lin-gengyou/py32-kitchen-scale/REQUIREMENTS.md

# 需求与实现对照 · v2.0.1

依据项目方确认的两份5kg V1.0文档，以及用户补充：SW4独立操作、单点20g默认标定、空秤稳定无操作120秒软件待机、外部供电默认、恢复ECB01C蓝牙。

| 需求 | 实现 |
|---|---|
| 称重链路 | HX711 A/128、10SPS；3点中值、动态3点/静态8点平均；默认按标定换算0.2g峰峰门限、8点满足500ms；2倍退出门限与均值锚点防慢漂 |
| 5000g量程 | >5000g为RANGE，≥5250g为OL；按毛重限制，去皮后容量保护继续生效 |
| 分度 | 0.1/0.5/1g，边界带滞回；内部mg计算，负净重与0.5g小负载保留 |
| 启动归零 | 保存空秤基线附近±0.1g，原始与滤波均稳定时归零；0.5g真实负载保持 |
| 去皮/归零 | SW4短按去皮、长按归零、菜单01清皮；BLE TARE复用新鲜/稳定/量程检查 |
| 显示 | HT1621B：重量、单位、稳定/皮重/负号、标定/菜单/故障；默认跳过数值第三位，菜单19恢复6位 |
| 标定 | 菜单07，1～3点、默认20g单点，各点1～5000g递增，正负ADC方向；最后一点整体提交 |
| 本机操作 | 菜单01～21包含全部设备设置、查看、维护，见按键指南 |
| 提示音 | 成功1声、错误3声，称重异常约每2秒3声；静音/有源/无源500Hz；1ms中断产生无源方波 |
| 电源 | 默认外部供电：电量-1、可查看输入与VDDA电压；可选锂电/碱性/镍氢、电压百分比、低电滞回与ADC故障恢复 |
| 待机 | 已知空秤、无皮重、稳定近零、无操作120秒；关闭LCD/HX711/LED，SW4或WAKE唤醒；PING保持待机 |
| 参数 | V4双128B记录、CRC32、代数序号、半页损坏回退、相同参数免写；V1/V2/V3迁移 |
| 元数据 | 板上录入设备编号/标定日期；版本2.0.1；发布包SHA256SUMS与源码哈希manifest |
| 蓝牙 | 9600/8N1、FFF0/FFF1/FFF2，5～10Hz重量、带序号去皮与成功/失败去重、状态同步/心跳/唤醒 |
| 终端界面 | 浏览器显示净重/稳定/皮重/电源/错误、g/kg/oz/lb:oz、去皮/唤醒、分包/粘包、超时重试、断线重连并重新订阅 |
| 可靠性 | 约4秒IWDG，DBGMCU时钟与暂停冻结；程序16KB、独立4KB配置区 |
| 彩屏 | 可操作界面预览、共享总线与资源方案见docs/color-display.md；型号尚未知，当前主显示为段码LCD |

## 软件检查

四个PIO环境构建；真实按键时序模拟；20g单点与1/2/3点正负标定；非线性净重、毛重限值、负数、0.5g保持、待机/唤醒、超时/回绕；V1/V2/V3迁移和全部半页写入截断；电压/百分比/低电滞回/故障门控；稳定噪声/真实0.5g阶跃/慢加料/手动门限；5位显示绕行；BLE分包/去重/失败缓存/旧序号/回绕/不交错发送。

合成8小时10Hz共288000帧，合成24小时10SPS共864000样本。浏览器协议和模拟GATT界面覆盖连接、去皮ACK、单位转换、断线空白、重连订阅、主动断开和演示。

## 整机验收指标

| 指标 | 测量方法 |
|---|---|
| 0.5g起称、分区±0.2/±1/±3g | 安装完成的5kg传感器与秤盘、对应区间标准砝码。20g为当前入门标定点，使用更大质量核对全量程 |
| 静态稳定≤1.5秒 | 实际加载到稳定标志的时间，包含机械振动、ADC建立与采样 |
| 重复10次、四角偏载 | 同砝码重复放置及改变位置 |
| 空秤10分钟漂移≤0.5g | 固定安装、温度和供电 |
| BLE 8小时、整机24小时 | 实物模块/终端/无线环境/传感器连续记录，与合成调度检查分别计量 |

显示实物反馈：数值第三位全亮仍为7，而HT1621的32项RAM读回正确。当前版正常显示绕过该位，自检仍点亮所有物理段。v2.0.1已通过CMSIS-DAP下载，并核对程序字节与4KB配置区保留；运行时已恢复20g旧标定并测得正常ADC状态，VDDA约5.1V。全量程误差与无线长测按上表继续测量。

原始依据：[产品需求](docs/requirements/01_厨房电子秤产品需求规格书_5kg_V1.0.docx)、[设计说明](docs/requirements/02_厨房电子秤项目设计说明书_5kg_V1.0.docx)。操作：[完整指南](docs/button-guide.md)。
