lin-gengyou/py32-kitchen-scale/docs/requirements/01_厨房电子秤产品需求规格书_5kg_V1.0.docx

厨房电子秤产品需求规格书

5 kg量程 · 简版

硬件平台：PY32F002A + HX711 + ECB01C + 显示屏 + 按键 + 蜂鸣器

文档项目 | 内容
文档类型 | 电子秤需求产出
文档版本 | V1.0
产品量程 | 最大称量 5000 g
产品定位 | 家用及教学烹饪辅助称重，不用于贸易结算
编制日期 | 2026年10月30日

# 1 产品定位

本产品是一台5 kg厨房电子秤，主要用于家庭做饭、烘焙、配料和教学做菜。用户可以一次放上物体称重，也可以放置容器后去皮，再边加料边观察重量。电子秤可与RK3566小平板通过蓝牙联动，但不用于商品贸易结算。

# 2 主要指标

项目 | 要求 | 说明
最大量程 | 5000 g | 已确认
起称目标 | 0.5 g | 小于0.5 g也不强制归零，尽量显示实测值
显示分度 | ≤200 g：0.1 g >200～1000 g：0.5 g >1000～5000 g：1 g | 分段显示，阈值附近防止反复跳变
目标误差 | ±0.2 g / ±1 g / ±3 g | 分别对应三个重量区间
稳定时间 | ≤1.5秒 | 静态加载、秤台无明显振动
刷新速度 | 约5～10次/秒 | 支持连续加料
超载提示 | 约5250 g以上显示OL | 停止输出正常重量

说明：低重量段0.1 g显示、0.5 g起称和±0.2 g误差均为优先设计目标。不得把低于2 g的物体直接归零；最终能力以5 kg传感器、秤台和整机测试结果为准。

# 3 功能需求

功能 | 简要要求
开机归零 | 确认空秤且稳定后归零；平台晃动或检测到小重量时不更新零点
去皮 | 实体按键和平板都能去皮；不稳定时拒绝去皮并提示
稳定显示 | 动态时实时变化，稳定后显示稳定标志
负重量 | 取走已去皮容器后允许显示负值，不强制清零
异常提示 | 超载显示OL；传感器异常显示ERR；低电显示电量提醒
单位 | 基本单位为g，可扩展kg、oz、lb:oz
蜂鸣器 | 按键有效一声，成功一声，错误或超载三声，可静音
掉电保存 | 标定参数、单位、蜂鸣和自动关机设置掉电保存

# 4 蓝牙和平板要求

- 主控与ECB01C串口统一为9600 bps、8N1；手机和平板连接BLE不需要设置串口波特率。
- FFF1用于上报重量与状态，FFF2用于接收去皮等控制命令。
- 平板显示净重、稳定状态、连接状态、电量和错误；断线后自动重连。
- 去皮命令必须返回成功或失败结果，不能只看重量是否接近0来猜测。

# 5 验收要求

项目 | 通过条件
称重 | 使用0.5 g、1 g、2 g及更大关键砝码至5000 g测试，满足对应区间误差
稳定性 | 同一砝码重复10次，显示不明显跳动；空秤10分钟漂移≤0.5 g
去皮 | 稳定时成功归零，不稳定时拒绝；屏幕和平板结果一致
连续加料 | 重量连续变化，无明显停顿、倒跳或长时间拖尾
四角偏载 | 中心和四角加载均满足对应重量区间误差
异常 | 超载、断传感器、低电时提示正确，不输出伪造的正常重量
蓝牙 | 连续连接8小时不死机，断开后能重连，命令不重复执行

# 6 当前待确认

- 确定具体5 kg称重传感器型号，并确认灵敏度、综合误差、蠕变、温漂和过载能力。
- 冻结秤台结构、传感器安装方式和机械限位，再做四角偏载与全量程验证。
- 如果样机无法稳定达到0.5 g起称、0.1 g显示和±0.2 g低段误差，应优先改善传感器、供电和机械结构。
