lin-gengyou/py32-kitchen-scale/docs/requirements/02_厨房电子秤项目设计说明书_5kg_V1.0.docx

厨房电子秤项目设计说明书

5 kg量程 · 简版

硬件平台：PY32F002A + HX711 + ECB01C + 显示屏 + 按键 + 蜂鸣器

文档项目 | 内容
文档类型 | 项目设计文档
文档版本 | V1.0
产品量程 | 最大称量 5000 g
产品定位 | 家用及教学烹饪辅助称重，不用于贸易结算
编制日期 | 2026年10月30日

# 1 总体方案

项目继续使用现有硬件：PY32F002A主控、HX711、ECB01C蓝牙模块、现有显示屏、按键、蜂鸣器和电源电路；称重传感器选用5 kg单点式全桥传感器。固件按新的厨房秤需求重新设计，不受原程序结构限制。

模块 | 作用
5 kg传感器 | 把重量转换成微弱差分信号
HX711 | 采集传感器信号，默认A通道、128倍增益、10 SPS
PY32F002A | 滤波、标定换算、去皮、显示、蜂鸣和故障处理
ECB01C | 把主控串口数据透明传输到BLE
RK3566平板 | 显示重量、执行去皮、配合做菜流程

# 2 硬件设计

- 传感器使用5 kg铝合金单点梁、四线全桥，建议灵敏度1.0～2.0 mV/V。
- 传感器固定端和受力端按厂家图纸安装，秤盘中心与受力中心对齐。
- 秤台应有足够刚度和机械限位；线束、电池和外壳不能碰到秤盘形成分流力。
- HX711传感器线尽量使用屏蔽或双绞线，模拟供电稳定，去耦电容靠近芯片。
- 电池低电、充电和主控复位期间都要测试称重，避免电源变化造成跳重。

# 3 固件结构

任务 | 建议周期 | 工作内容
采样 | HX711数据就绪，约10 Hz | 读取原始ADC、检测超时
称重 | 每个新样本 | 滤波、标定、稳定判断、分度和超载
按键/蜂鸣 | 10 ms | 消抖、去皮请求、非阻塞音型
显示 | 100～200 ms | 刷新重量、单位、稳定、电量和错误
蓝牙 | 100～200 ms | 上报状态、接收命令、维护连接
电源/看门狗 | 500～1000 ms/按芯片配置 | 电量、自动关机、异常复位

所有任务都采用非阻塞方式，不能用长延时等待HX711、蜂鸣器或蓝牙。屏幕和平板使用同一个WeightState对象，避免两端显示不同结果。

# 4 称重与去皮算法

1. 读取HX711原始值，检查数据就绪、超时和异常范围。

2. 用中值或截尾均值去除偶发尖峰，再进行适度平滑，避免小重量被滤掉。

3. 减去零点Offset，应用比例系数或分段修正，得到未量化重量。

4. 状态机区分空秤、动态加载、稳定候选、稳定锁定、卸载和故障。

5. 按重量区间选择0.1 g、0.5 g或1 g分度，最后一步再四舍五入。

6. 生成统一WeightState，同时提供给屏幕和蓝牙。

状态 | 处理方式
空秤 | 仅在确认空秤、连续稳定≥3秒且净重绝对值≤0.1 g时慢速跟踪；检测到加载立即停止
动态加载 | 快速跟随，不显示稳定
稳定候选 | 连续多个样本波动小于阈值后确认稳定
稳定锁定 | 抑制小噪声；持续变化后返回动态
故障 | 停止正常重量发布，显示ERR并等待恢复自检

去皮时先检查最近重量是否稳定。稳定则保存新皮重、清空滤波状态并发布0；不稳定则保留旧皮重并返回UNSTABLE。普通称重时不得把低于2 g的物体直接归零。去皮只能改变净重零点，不能绕过5 kg总负载限制。

# 5 蓝牙和平板通信

项目 | 设计
主控↔ECB01C | 9600 bps、8N1、无流控；两边必须一致
BLE特征 | FFF1 Notify上报，FFF2 Write下发
重量帧 | W,序号,净重,稳定,皮重,电量,状态 + CRLF
去皮命令 | TARE,序号 + CRLF
命令应答 | ACK,TARE,序号 或 ERR,TARE,序号,原因
平板处理 | 按CRLF组帧，处理拆包、粘包、断线和自动重连

示例：W,1024,256.4,1,120.0,78,OK 表示序号1024、净重256.4 g、已稳定、皮重120.0 g、电量78%、状态正常。

# 6 标定与测试

1. 整机放在水平硬质台面，预热并检查秤盘没有机械干涉。

2. 空载采集零点，依次加载500 g、2500 g和5000 g砝码完成主标定。

3. 计算比例系数并检查线性，必要时保存分段修正参数。

4. 使用0.5 g、1 g、2 g、10 g、50 g和200 g砝码重点验证小重量，再测试重复性、回程、四角偏载和去皮。

5. 写入设备编号、标定参数、日期和固件版本，并用CRC校验。

6. 完成连续加料、超载、断传感器、低电、蓝牙重连和24小时运行测试。

- 标定参数使用双备份或版本号+CRC；写入失败时使用上一份有效参数。
- 具体5 kg传感器和秤台结构未冻结前，不承诺最终误差。
- 开发顺序建议：先验证传感器与秤台，再完成称重算法，然后联调蓝牙和平板，最后做整机验收。
