lin-gengyou/py32-kitchen-scale/docs/manuals/01_厨房电子秤功能逻辑与代码图解_1.0.2.pdf

### 开发阅读 / 源码与实际行为

# 厨房电子秤

# 功能逻辑与代码图解

## 5kg厨房秤 · PY32F002A / HX711 / ECB01C

## 固件开发版 1.0.2 · 协议 2 · 2026年11月5日

### 面向程序开发与联调阅读。按启动、采样、称重、交互、通信和参数恢复的顺序，把真实源码图与它产生的 实际行为配对说明。代码图保留文件名与行号，便于回到 VS Code 查阅。


### 阅读基线为当前本地固件开发版1.0.2。编译和桌面模拟已完成，实物烧录、称重精度、屏幕、电池和 无线链路的验收状态在正文逐项列出。

源代码快照 scale_basic.c / SHA256 0692ed771e531d16def9

固件1.0.2 / 协议2 · 代码与模拟状态见正文 | 1 / 43

功能逻辑与代码图解 | 阅读导航

# 如何阅读本册

### 每个模块按源码图、触发条件、处理过程和结果展开。代码图由当前源文件直接生成，长行仅作视觉折行， 续行不增加源代码行号。图下给出源码哈希前缀，完整快照信息见末页。

硬件输入、C 类型和默认参数 | 3
上电恢复、主循环和引脚初始化 | 6
HX711、尖峰处理、平均与判稳 | 10
分段标定、归零和去皮 | 15
错误状态、分度和重量帧 | 19
串口组帧、序号去重和命令 | 23
实体按键和蜂鸣提示 | 28
空秤跟踪、120秒待机和唤醒 | 30
双页配置、CRC和失败回退 | 33
看门狗、构建与验证范围 | 38
函数索引与来源快照 | 41

### 操作次序、PCB 接线、所有命令与错误处理，配套查阅第二册《PCB操作与联调指南》。本册的“预期 输出”说明代码行为，实物测试状态以验证页为准。

功能逻辑与代码图解 | 01 硬件与数据

# 代码如何对应到这块板

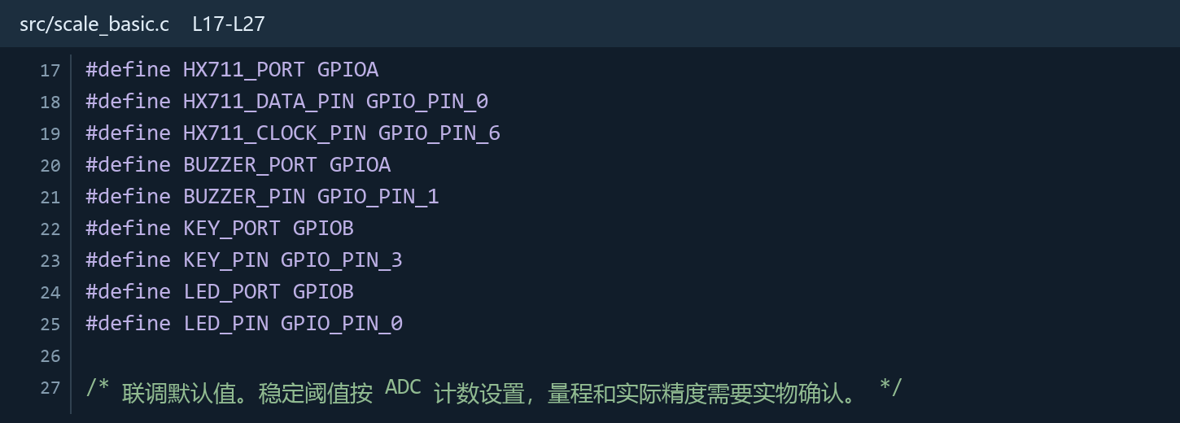
[picture p11: figure]

源码图 src/scale_basic.c 第 17-27 行 · SHA256 0692ed771e53

### 实际功能

网络或器件 | MCU 引脚 | 代码中的用途
HX711 DOUT / PD_SCK | PA0 / PA6 | 读取称重计数；时钟拉高还用于待机掉电
SW4 / LED2 | PB3 / PB0 | 功能键输入 / 运行心跳
蜂鸣器驱动 | PA1 | 有源通断或无源方波
ECB01C 串口 | PA2 TX / PA3 RX | 9600bps、8N1 收发
SWD | PA13 / PA14 | 保留给下载和调试
两块显示接口 | PA4 / PB2 片选 | 初始化为高，显示驱动待接入

宏名称把物理引脚集中在文件开头。后续阅读 KEY_PIN 或 HX711_CLOCK_PIN 时，可回到这里定位。电池

### 检测接 PB1，当前采样和百分比换算尚未实现。[H1]

功能逻辑与代码图解 | 01 硬件与数据

# 配置变量与统一重量状态

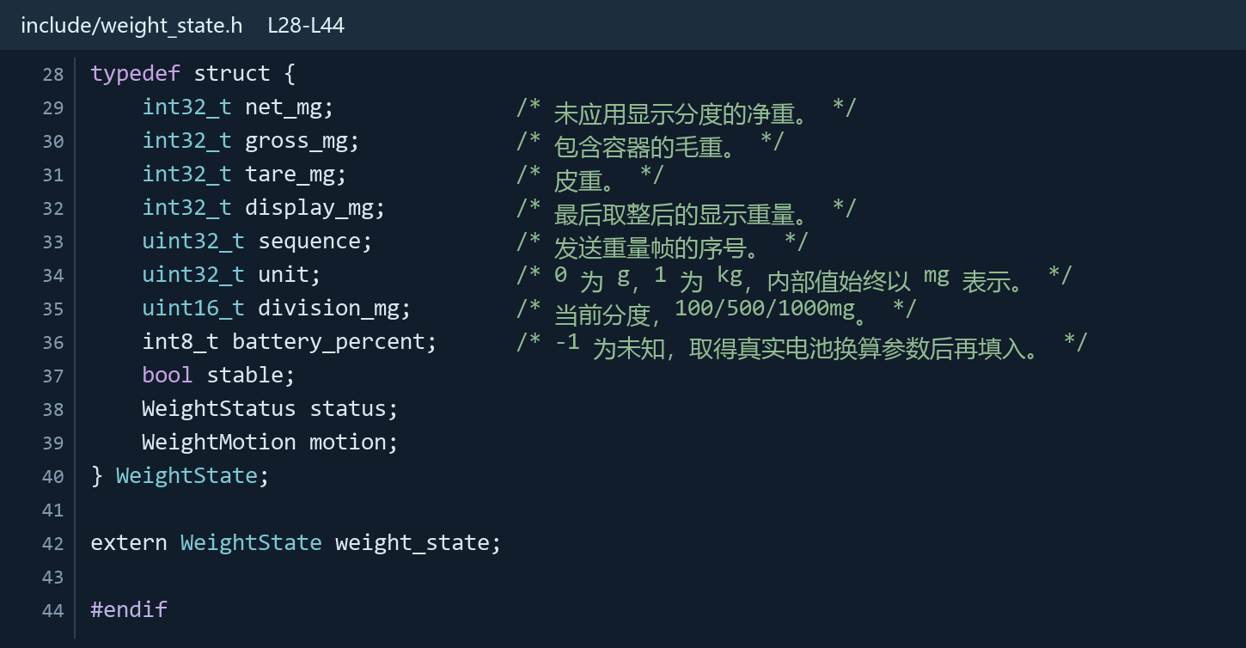
[picture p12: figure]

源码图 include/weight_state.h 第 28-44 行 · SHA256 d49d46442fe9

### 实际功能

WeightState 像一张当前测量状态表。net_mg、gross_mg 和 tare_mg 分别是未量化净重、毛重和皮重， display_mg 才是按分度取整后的数值。蓝牙使用这张表生成重量帧，屏幕驱动接入后也读取它。

表达式 | 用白话理解
battery_percent = -1 | 尚未得到电量数据，界面可显示“未知”或 --
division_mg = 100 | 分度100mg，即0.1g；这项数值描述显示步长
ScaleConfig saved_config | Flash 中参数的运行副本，保存标定、单位和待机等设置
static | 文件级变量只在当前 .c 文件内部直接访问
typedef / enum / bool | 给类型起名 / 定义可选状态 / 表示真或假

功能逻辑与代码图解 | 01 硬件与数据

# 默认数值分别控制什么

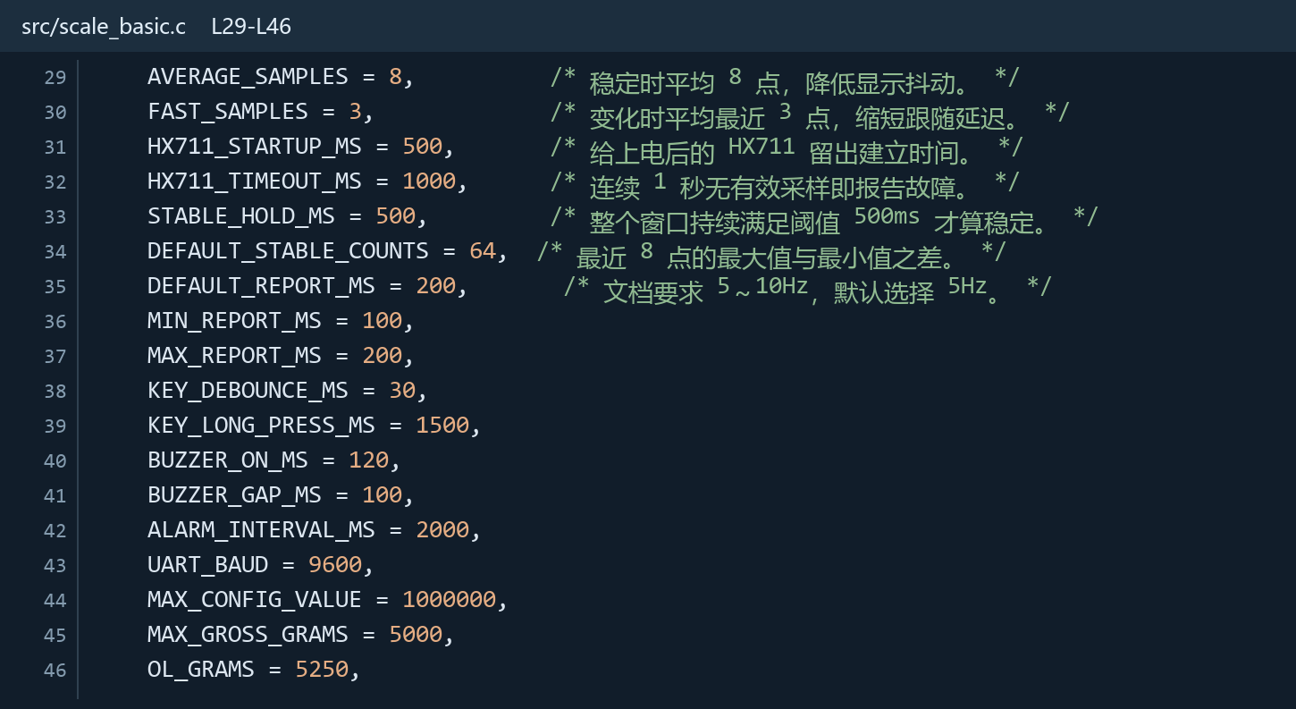
[picture p13: figure]

源码图 src/scale_basic.c 第 29-46 行 · SHA256 0692ed771e53

### 实际功能

参数 | 对应行为
8点 / 3点 | 稳定时平均8点，动态时平均最近3点
500ms / 1000ms | 上电建立时间 / 连续无有效读数的故障门限
64计数、500ms | 8点峰峰值不超过64且持续500ms后判稳
200ms，允许100～200ms | 默认每秒5帧，可设每秒5～10帧
30ms / 1500ms | 按键消抖 / 长按识别
120ms / 100ms | 每声持续时间 / 声间间隔

### 64 的单位是 ADC 计数。每克对应多少计数由传感器和标定决定，需要在样机上测噪声并调整。

功能逻辑与代码图解 | 02 启动与调度

# 上电后先恢复哪些东西

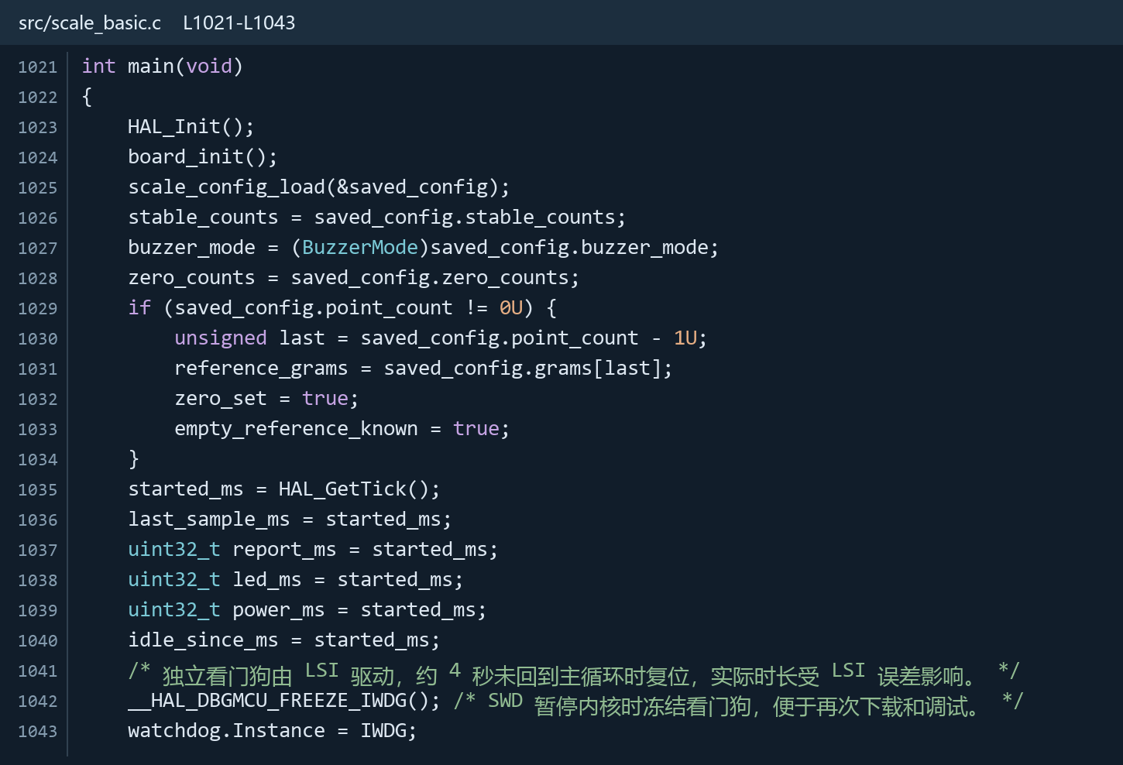
[picture p14: figure]

源码图 src/scale_basic.c 第 1021-1043 行 · SHA256 0692ed771e53

### 实际功能

### 先初始化 HAL 和板级引脚，再读取双页 Flash 配置。有效标定存在时，恢复空秤基线与标定点，允许进入 克数换算；没有有效标定时，恢复默认设置并上报 UNCAL。

### 皮重是本次运行的状态，上电初值为0。去皮序号缓存、消息序号、临时上报设置同样从初始值开始。已有 标定只提供空秤参考，开机放着0.5g物体时仍会保留这个真实负载。

功能逻辑与代码图解 | 02 启动与调度

# 主循环怎样并行照顾各功能

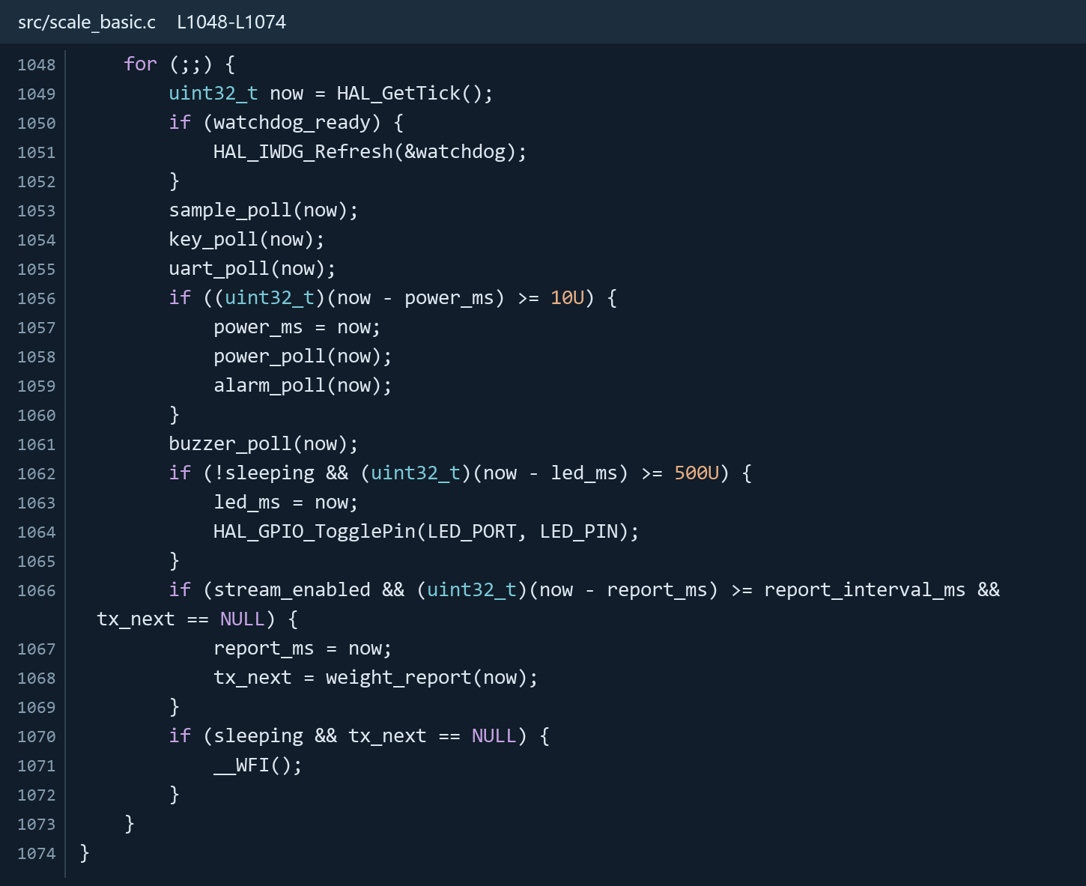
[picture p15: figure]

源码图 src/scale_basic.c 第 1048-1074 行 · SHA256 0692ed771e53

### 实际功能

每轮依次处理采样、按键、串口、蜂鸣器。电源与报警约每10ms检查一次，LED 每500ms翻转，重量按 100～200ms的周期发布。每个任务快速返回，下一轮继续检查。

### STREAM 0 只暂停周期上报。采样、按键、故障状态和心跳继续运行。待机时允许执行 WFI 等待中断，串 口或按键活动会唤醒任务流程。

功能逻辑与代码图解 | 02 启动与调度

# 引脚初始化为何先写电平

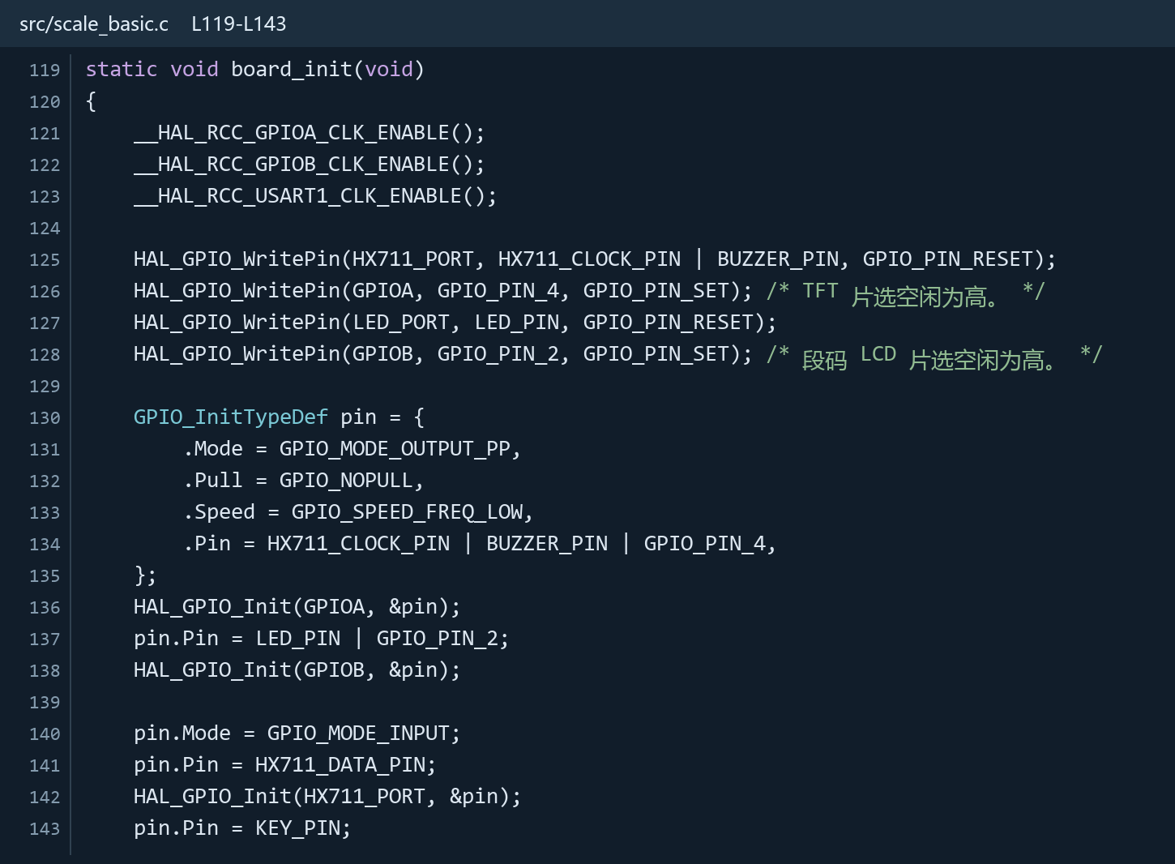
[picture p16: figure]

源码图 src/scale_basic.c 第 119-143 行 · SHA256 0692ed771e53

### 实际功能

先把 HX711 时钟、蜂鸣器和 LED 输出置低，把两个显示片选置高，再配置为输出。这样在切换引脚方向时

### ，各电路就有明确的初始状态。

PA0 配为输入读取 DOUT。PB3 使用上拉输入，SW4 按下时接地，因此程序读到低电平就认为按下。当前

### 显示驱动尚未更新屏幕内容。

引脚对应原理图网络，使用内部8MHz时钟，PF0/PF1继续留给显示相关接口。PA13/PA14保留给 SWD。[H1]

功能逻辑与代码图解 | 02 启动与调度

# 串口与毫秒计时怎样建立

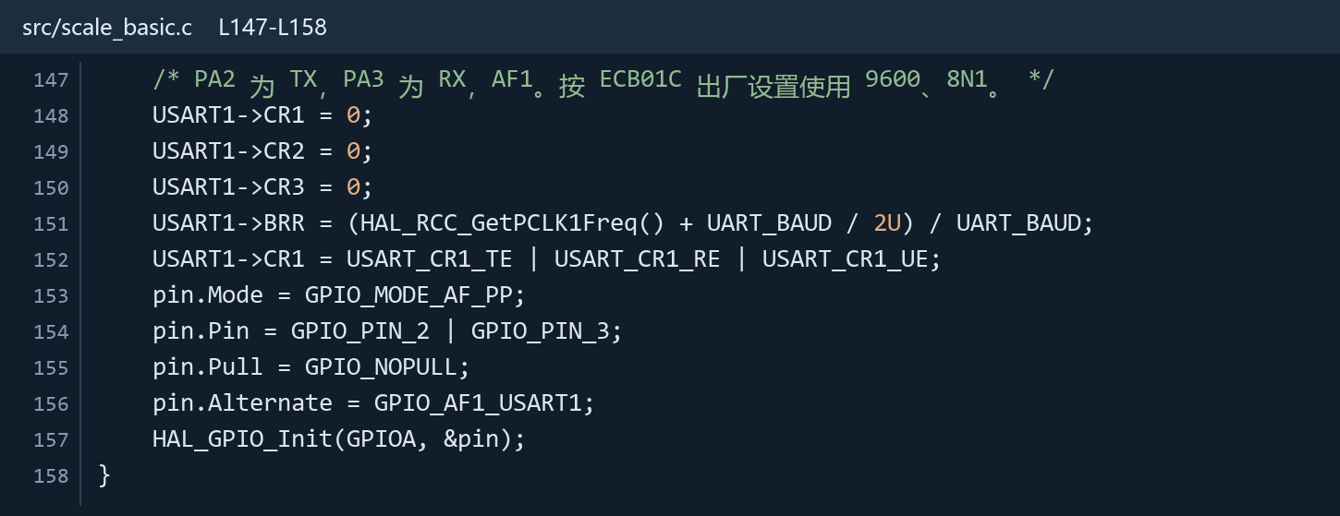
[picture p17: figure]

源码图 src/scale_basic.c 第 147-158 行 · SHA256 0692ed771e53

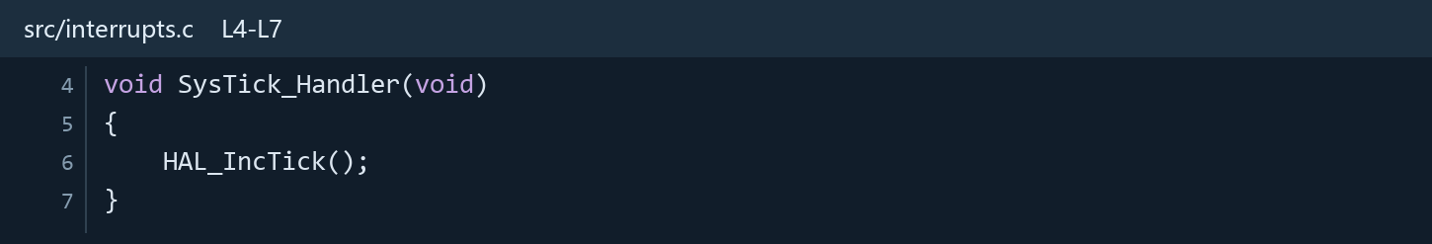
[picture p18: figure]

源码图 src/interrupts.c 第 4-7 行 · SHA256 a1e50cd591bc

### 实际功能

USART1 的 PA2 为发送、PA3 为接收，使用 AF1 复用。代码把波特率设为9600，字长和校验配置形成 8N1。它与ECB01C的串口侧必须匹配。

### SysTick 每毫秒更新 HAL 的计数。now 与上一次时间相减，就能判断是否到达上报、消抖或提示音时刻。 uint32_t 时间差支持计数回绕，代码避免长延时占住主循环。

环节 | 频率或单位
MCU 与 ECB01C 的串口 | 9600bps，传输速率
重量帧上报 | 默认5Hz，即每200ms一帧
HX711 新读数 | 由 RATE 硬件决定，设计方案为10SPS

功能逻辑与代码图解 | 03 采样与稳定

# HX711一帧读数怎样取得

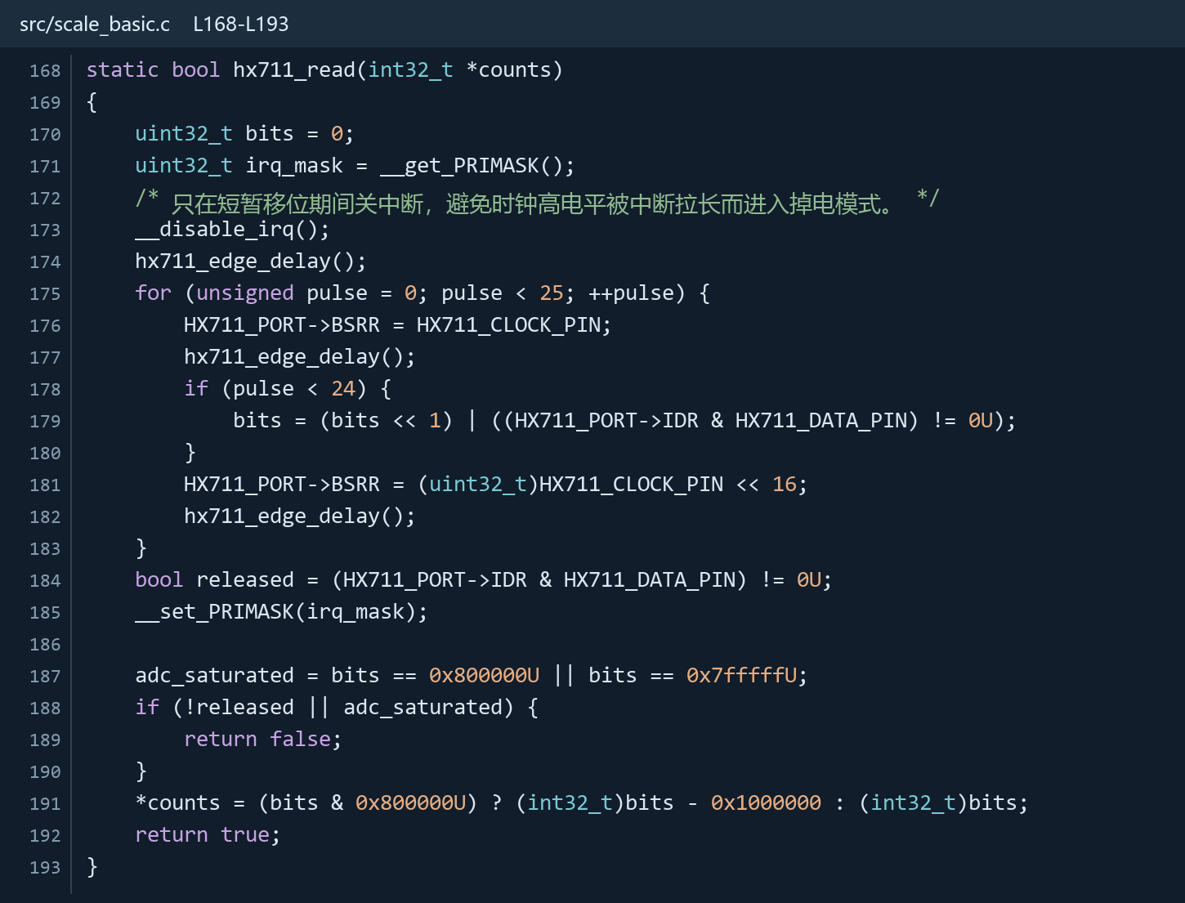
[picture p19: figure]

源码图 src/scale_basic.c 第 168-193 行 · SHA256 0692ed771e53

### 实际功能

DOUT 就绪后，前24个时钟读出有符号采样值，第25个脉冲选择下一次的A通道128倍增益。最高位为1时 把24位值扩展成负的 int32_t 计数。

### 短暂移位期间保存中断屏蔽状态并关中断，防止时钟高电平被中断拖长。读到正/负满码，或第25个脉冲后 DOUT未释放，会判定本次数据异常。实际高低脉宽仍需示波器验证。

功能逻辑与代码图解 | 03 采样与稳定

# 等待采样和超时怎样处理

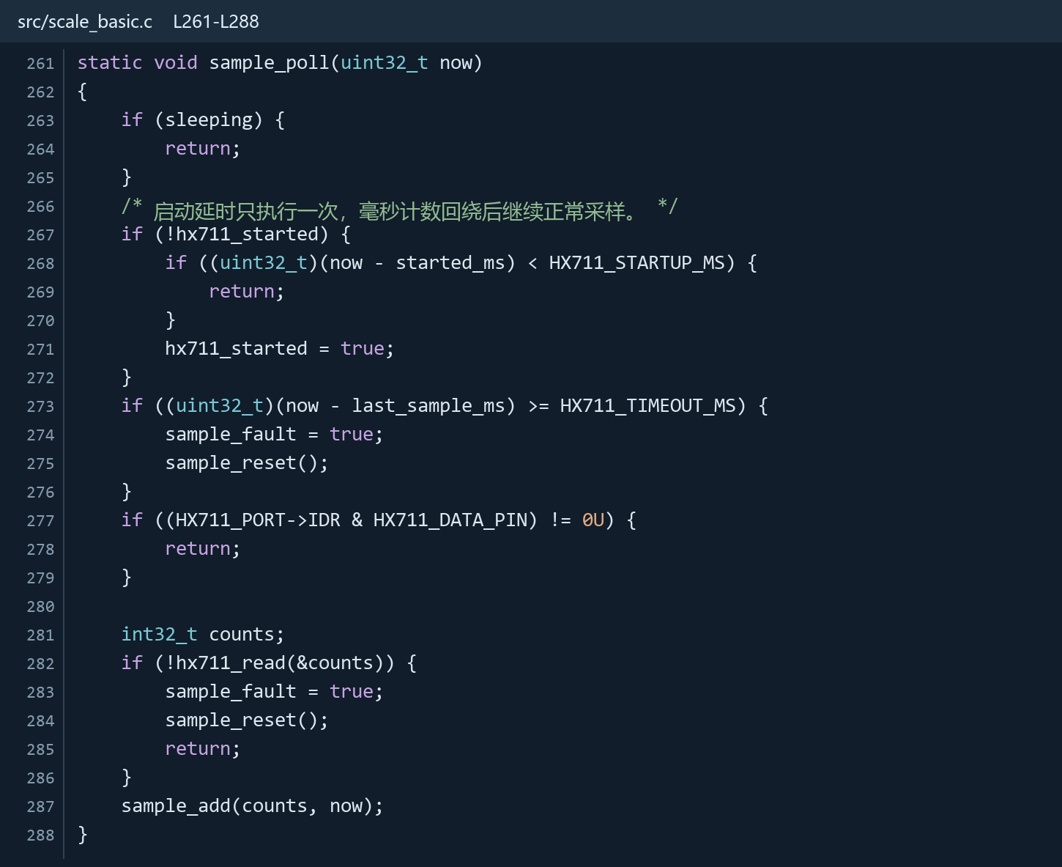
[picture p20: figure]

源码图 src/scale_basic.c 第 261-288 行 · SHA256 0692ed771e53

### 实际功能

### 启动建立时间只执行一次。DOUT仍为高时，本轮立即返回；有新结果才移位读取。连续1秒没有有效结果时 ，清空旧窗口并置故障，避免拿旧重量做去皮或归零。

### 待机时暂停读取。故障恢复后，必须重新积累有效样本；满码、超时和读取错误都通过统一状态转成 ERR，

正常重量字段留空。

功能逻辑与代码图解 | 03 采样与稳定

# 三点中值怎样去掉尖峰

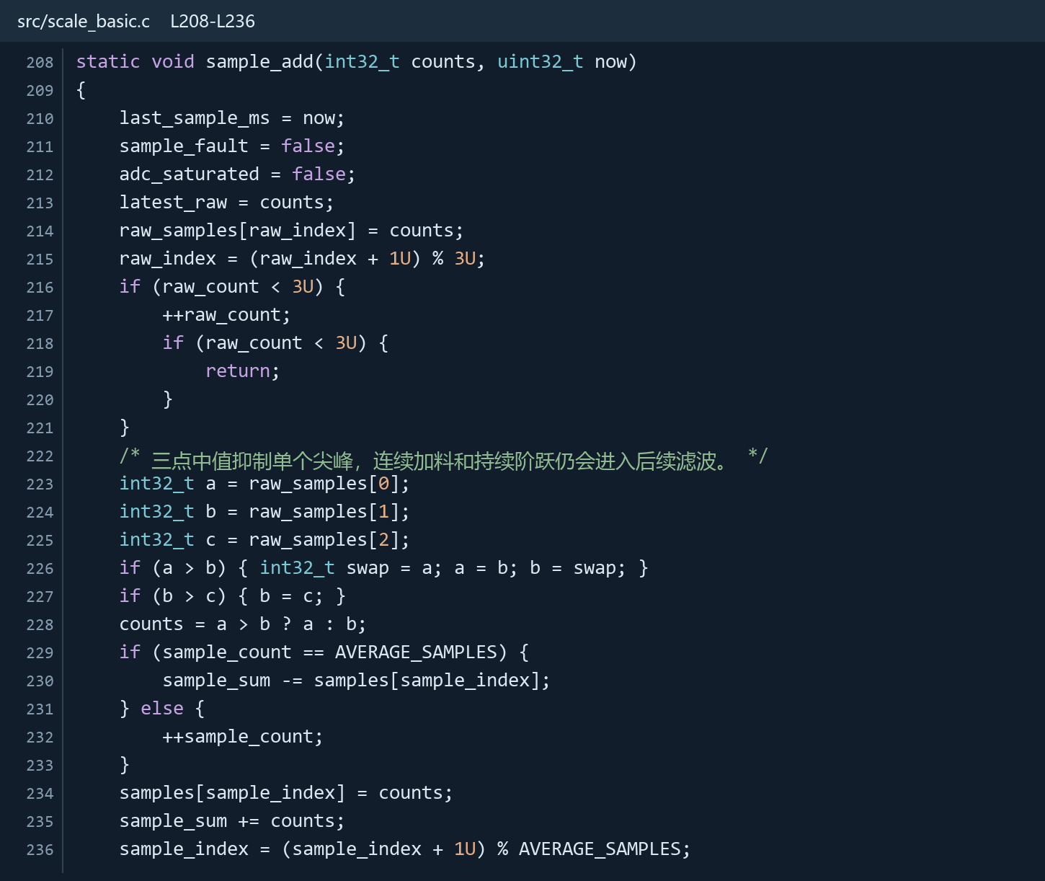
[picture p21: figure]

源码图 src/scale_basic.c 第 208-236 行 · SHA256 0692ed771e53

### 实际功能

先保留最近3个原始计数，再取中间大小的那个值送入平均窗口。例如100、101、7000的中值是101，单个 7000尖峰不会直接拉动显示。

### 持续加载会连续改变多个采样，仍能进入后续计算。此处没有把低于2g的重量硬设为0，也没有按重量大小

丢弃小信号。latest_raw 同时保留最新原始值，供诊断和近零检查。

功能逻辑与代码图解 | 03 采样与稳定

# 最近8点怎样判断稳定

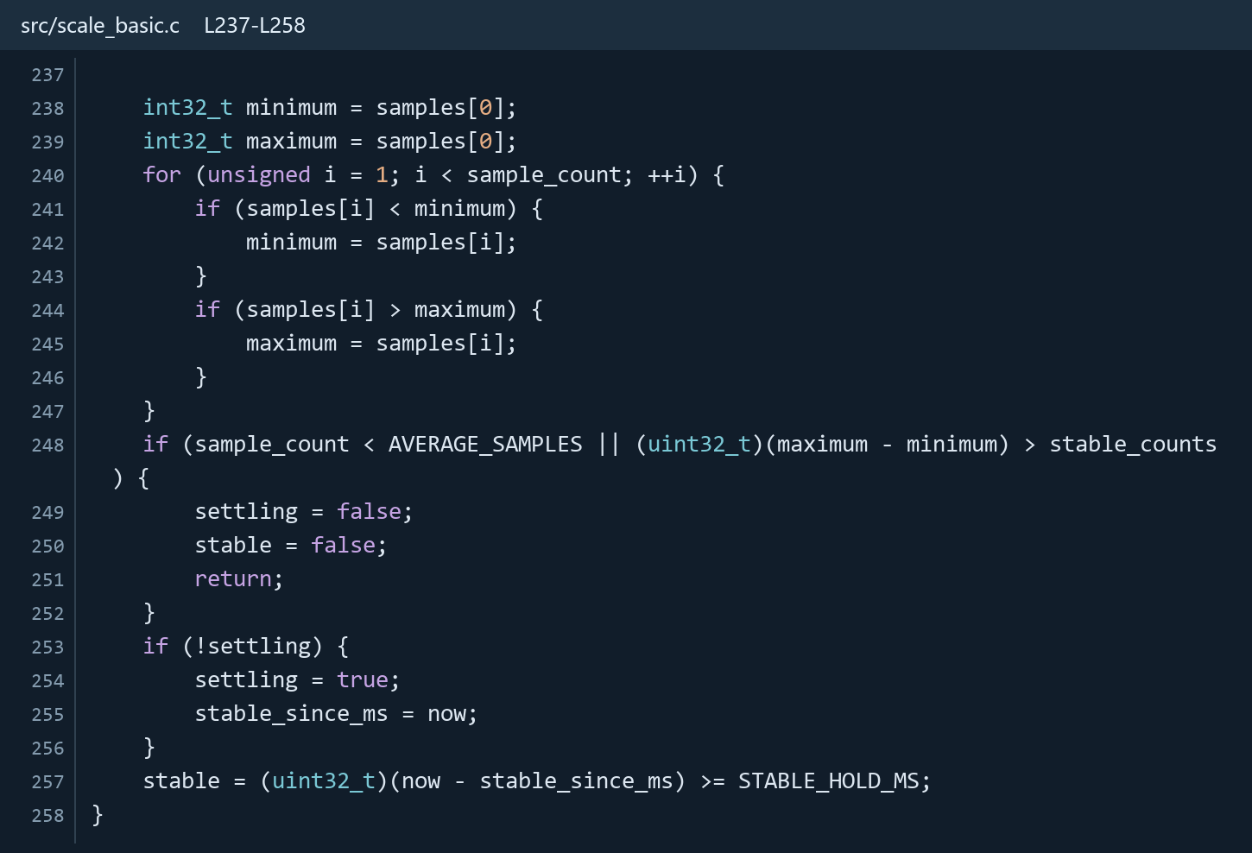
[picture p22: figure]

源码图 src/scale_basic.c 第 237-258 行 · SHA256 0692ed771e53

### 实际功能

### 环形窗口保存最近8点。每次收入一个值，就查窗口的最小值和最大值。窗口不足8点，或峰峰值超过

stable_counts，就清除稳定候选。

窗口满足条件后开始计时，连续500ms保持合格才置 stable。窗口1000～1040的峰峰值为40，低于默认64

### 计数；这仍需持续满足时间条件。加载或振动超过阈值会立即取消稳定标志。

功能逻辑与代码图解 | 03 采样与稳定

# 动态跟随和稳定平滑怎样切换

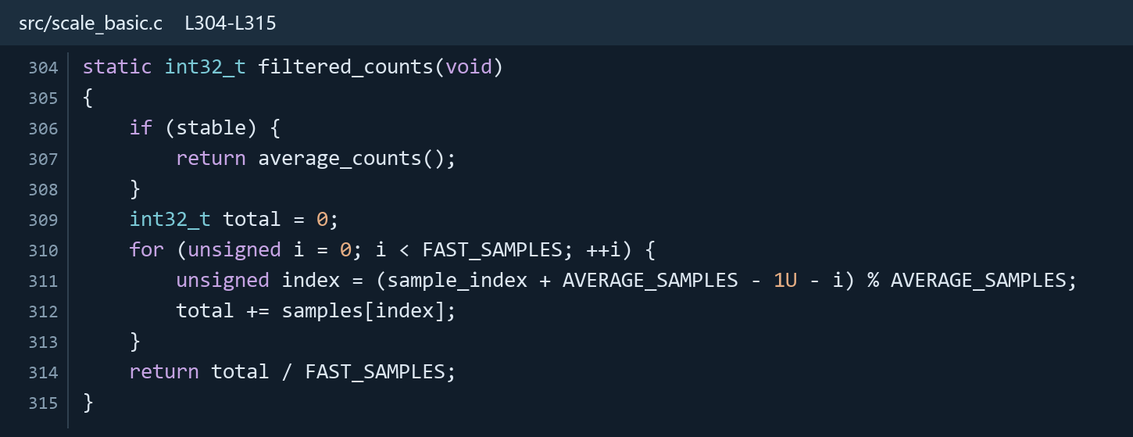
[picture p23: figure]

源码图 src/scale_basic.c 第 304-315 行 · SHA256 0692ed771e53

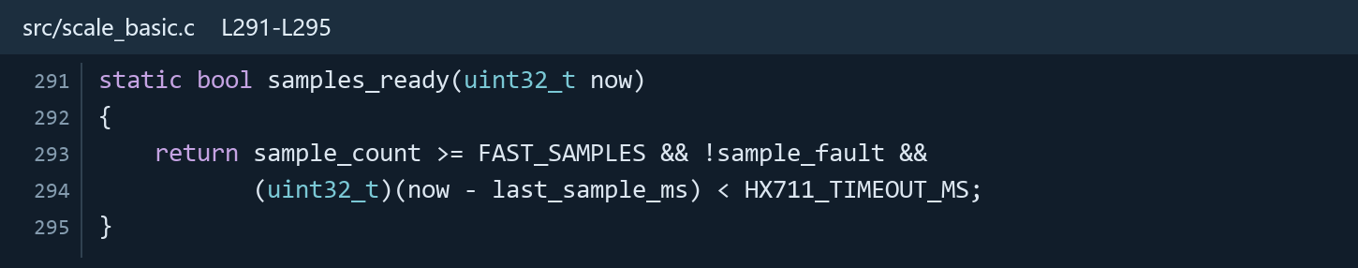
[picture p24: figure]

源码图 src/scale_basic.c 第 291-295 行 · SHA256 0692ed771e53

### 实际功能

### 动态时取最近3点平均，缩短连续加料的拖尾；stable 成立后取完整窗口平均，减小抖动。标定、归零和去 皮需要稳定窗口，统一用完整平均值建立基线。

samples_ready 还检查采样是否新鲜、是否有故障。刚启动或恢复时要先积累至少3点有效滤波样本。窗口

### 和时序决定的是算法响应，整机稳定时间还受机械结构、传感器与环境影响。

功能逻辑与代码图解 | 04 标定与称重

# ADC计数怎样变成克数

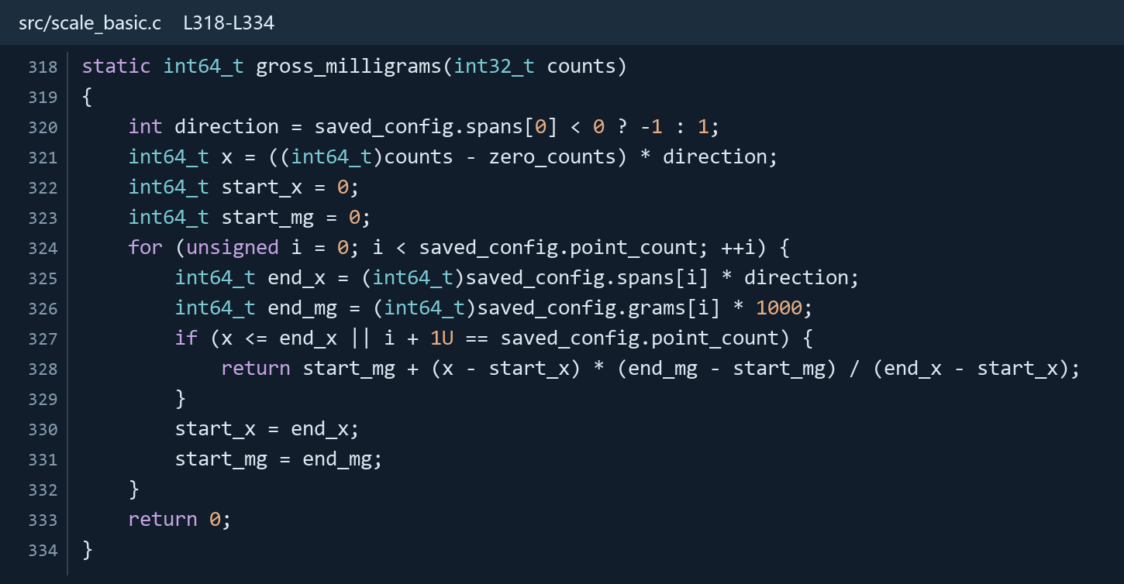
[picture p25: figure]

源码图 src/scale_basic.c 第 318-334 行 · SHA256 0692ed771e53

### 实际功能

### 空秤计数为原点，标定点保存砝码质量和对应计数差。程序找到相邻两个点，在这一小段内按比例插值；低 于零点和超过末点时，沿对应一段的斜率外推。

### 例如500g和2500g两个标定点之间，计数刚好在中间时换算为1500g。计数方向允许为负，适配加载后ADC 数值下降的接法。中间计算用 int64_t，输出先保留毫克，后续才应用显示分度。

曲线正确需要真实砝码和正确安装的传感器。固件支持三点修正，实际误差仍需按0.5g至5000g的验收

### 点测量。

功能逻辑与代码图解 | 04 标定与称重

# CAL怎样录入标定点

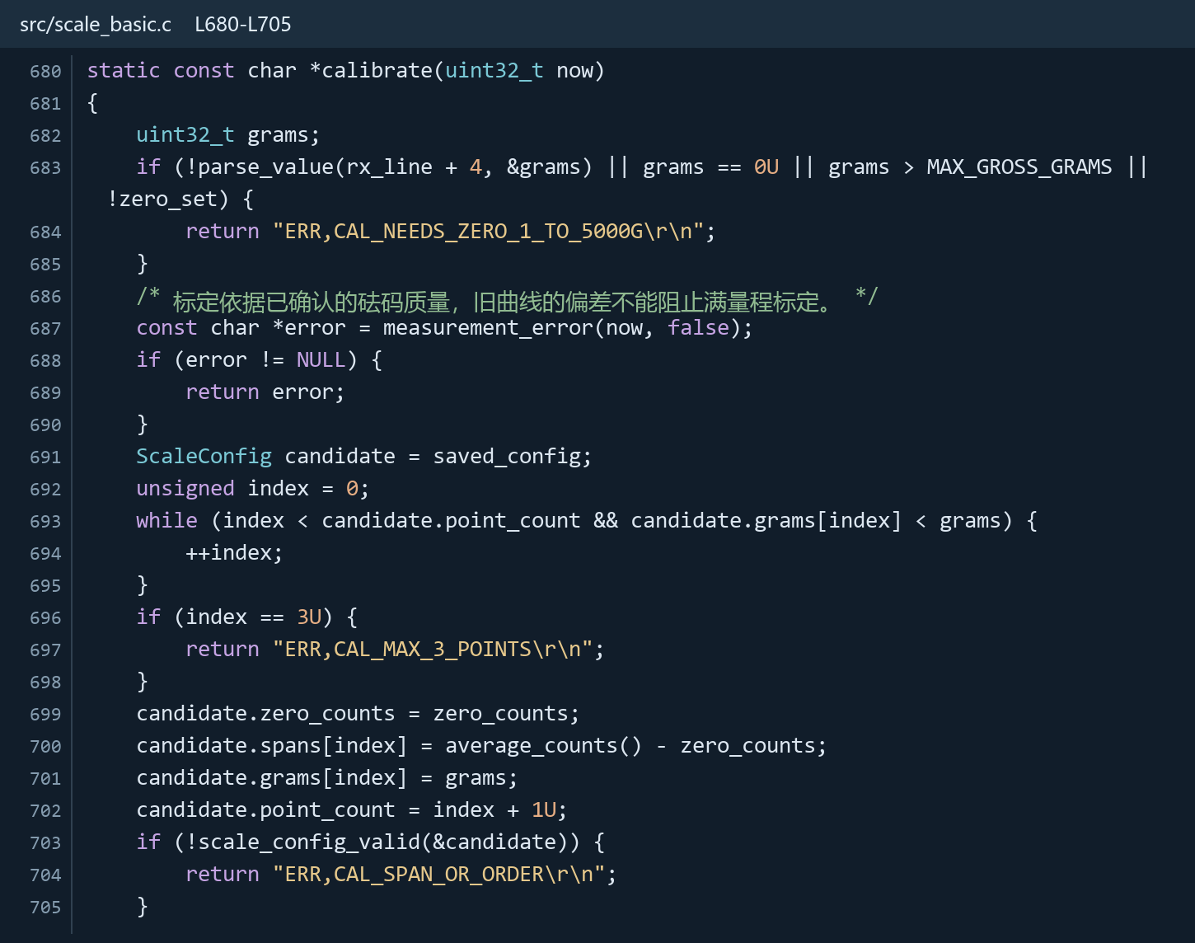
[picture p26: figure]

源码图 src/scale_basic.c 第 680-705 行 · SHA256 0692ed771e53

### 实际功能

### 命令接受1～5000的整数克数，要求已经建立空秤零点、最近数据新鲜且稳定。最多保存3点，录入同一或更 小质量时，后续标定点作废，需要重新录入。

### 初步曲线可能把真实5000g算得略大。标定命令依据操作者已确认的砝码质量进行修正，因此不会被旧曲线 的超量程结果阻止；计数方向、单调性和存储校验仍必须通过。

CAL 500
CAL 2500
CAL 5000
OK,CAL,SAVED

功能逻辑与代码图解 | 04 标定与称重

# ZERO怎样保护真实小负载

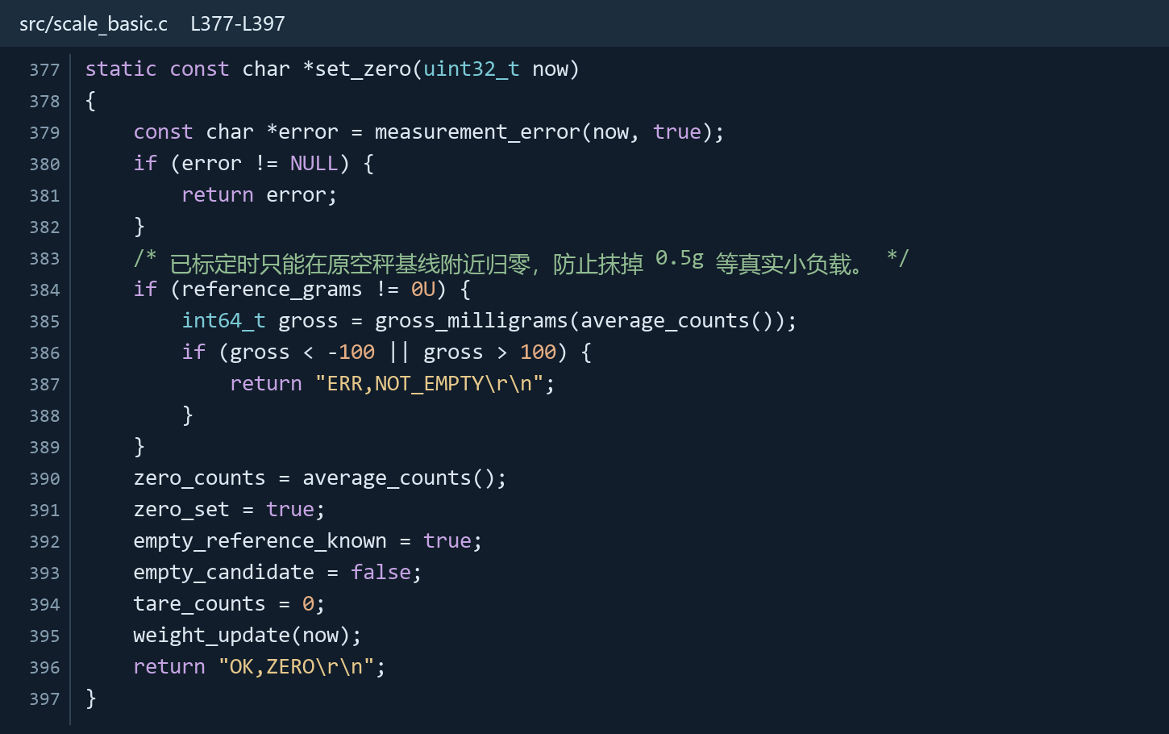
[picture p27: figure]

源码图 src/scale_basic.c 第 377-397 行 · SHA256 0692ed771e53

### 实际功能

归零前检查新鲜、稳定和毛重上限。已有标定时，还要求原空秤基线附近的毛重位于±0.1g内。0.5g物体会 得到 NOT_EMPTY，避免被归零操作吞掉。

### 成功后更新运行零点，保留标定曲线并清除皮重。第一次尚未标定时，ZERO是操作者对空秤的确认，随后

需要用真实砝码完成CAL。普通称重过程中，负重量和小重量继续按换算结果发布。

# TARE与ZERO分别改变什么

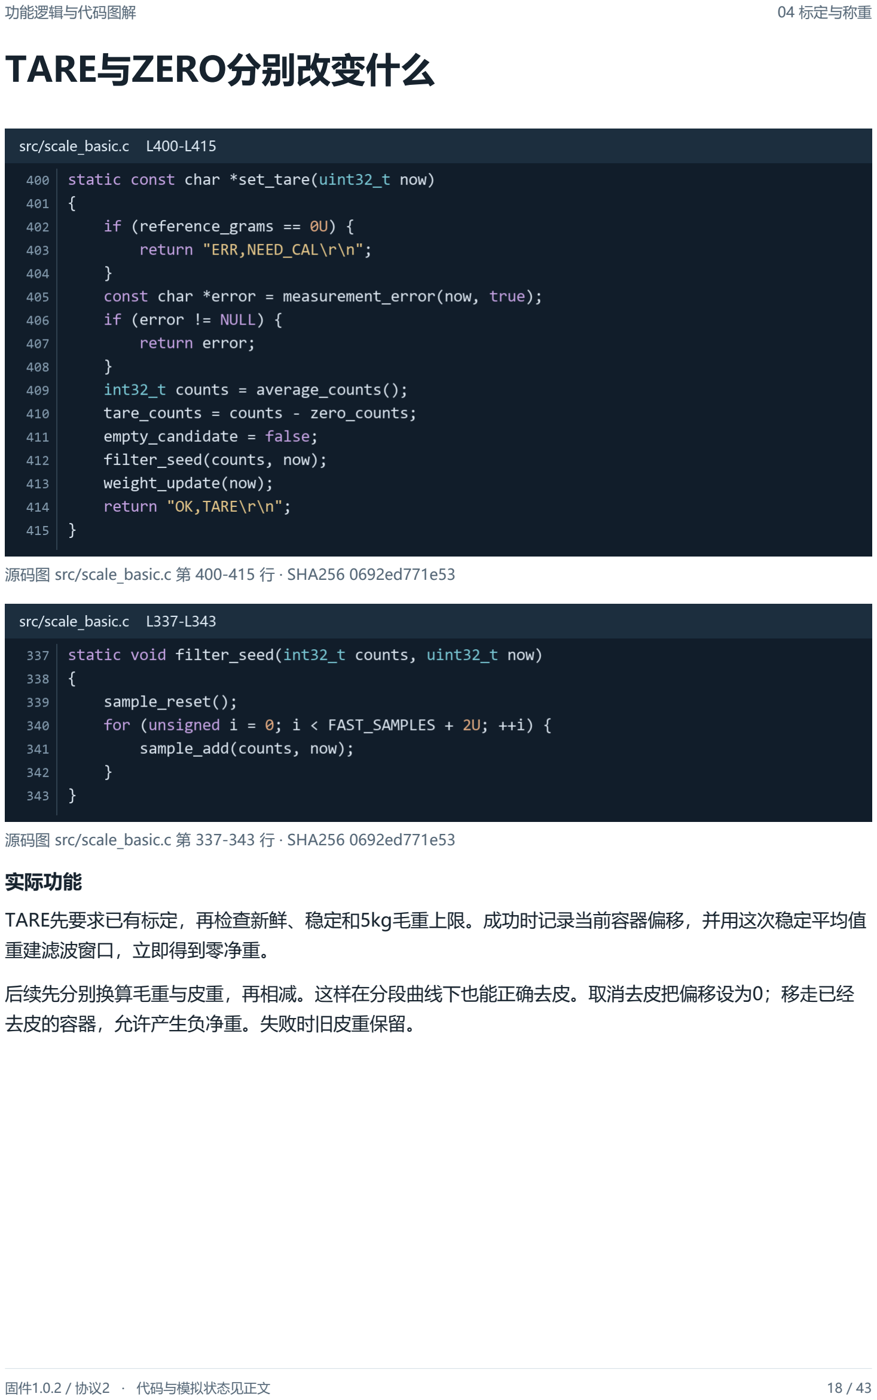
[picture p28: page 18]

功能逻辑与代码图解 | 04 标定与称重

源码图 src/scale_basic.c 第 400-415 行 · SHA256 0692ed771e53

源码图 src/scale_basic.c 第 337-343 行 · SHA256 0692ed771e53

### 实际功能

### TARE先要求已有标定，再检查新鲜、稳定和5kg毛重上限。成功时记录当前容器偏移，并用这次稳定平均值 重建滤波窗口，立即得到零净重。

### 后续先分别换算毛重与皮重，再相减。这样在分段曲线下也能正确去皮。取消去皮把偏移设为0；移走已经 去皮的容器，允许产生负净重。失败时旧皮重保留。

功能逻辑与代码图解 | 05 统一重量与显示

# 什么时候发布WAIT或ERR

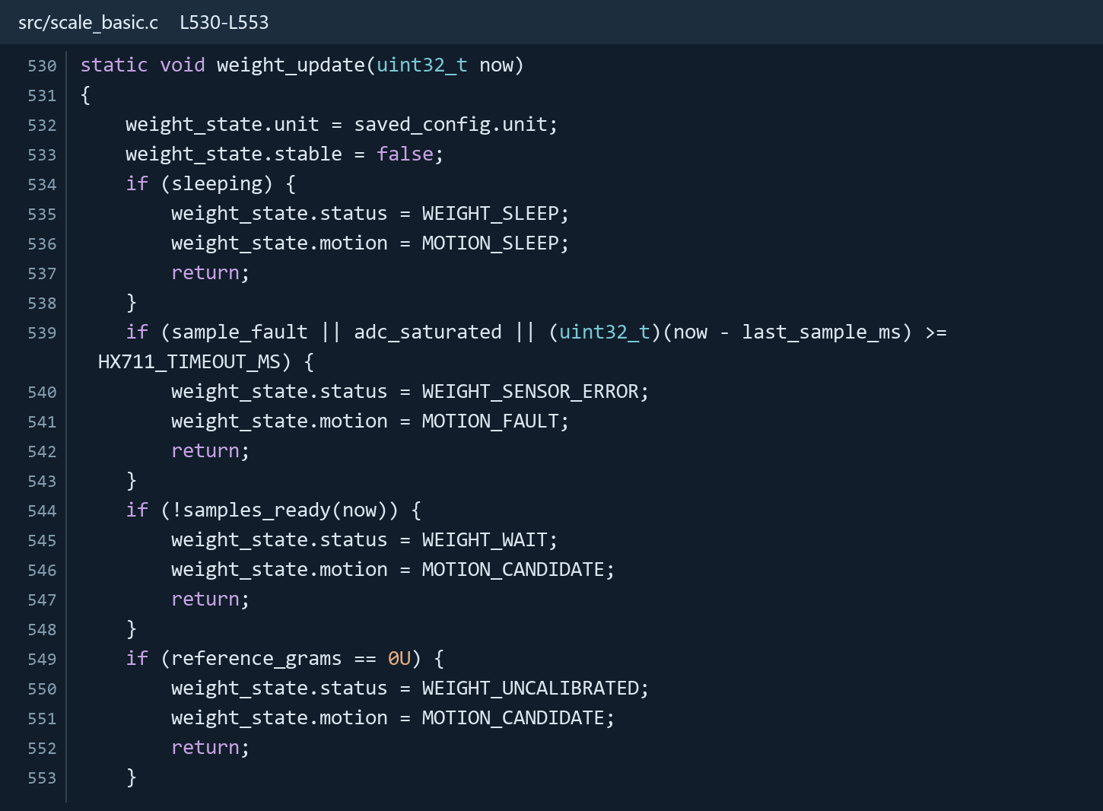
[picture p29: figure]

源码图 src/scale_basic.c 第 530-553 行 · SHA256 0692ed771e53

### 实际功能

条件 | 统一状态
软件待机 | SLEEP
HX711超时、满码或读取失败 | ERR
有效样本还不足 | WAIT
没有有效标定点 | UNCAL

### 这些分支先把稳定标志清除，并停止发布正常重量数字。状态对象里可能仍保留上一次数值，接收端应先检

查 status；蓝牙报文会主动把无效重量字段留空。

功能逻辑与代码图解 | 05 统一重量与显示

# 5kg上限与OL怎样区分

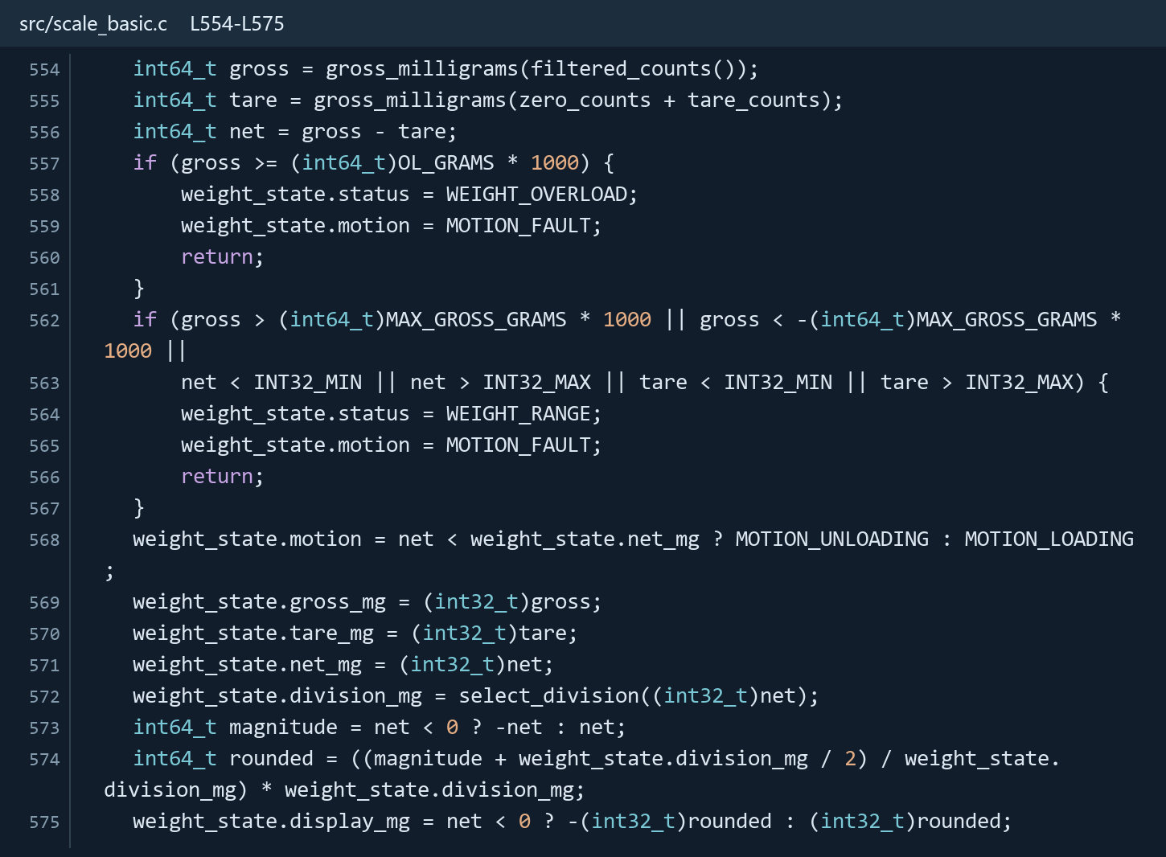
[picture p30: figure]

源码图 src/scale_basic.c 第 554-575 行 · SHA256 0692ed771e53

### 实际功能

毛重 | 状态和输出
≤5000g且其他检查通过 | OK，可发布正常重量
>5000g且<5250g | RANGE，正常重量字段留空
≥5250g | OL，正常重量字段留空

毛重包含容器。例如3000g容器已去皮，再加入2001g物体，总负载5001g，仍会进入RANGE。归零、去皮

### 保留5kg限制；在已确认砝码质量下执行标定，可以修正旧曲线偏差。

# 分度和四舍五入放在哪一步

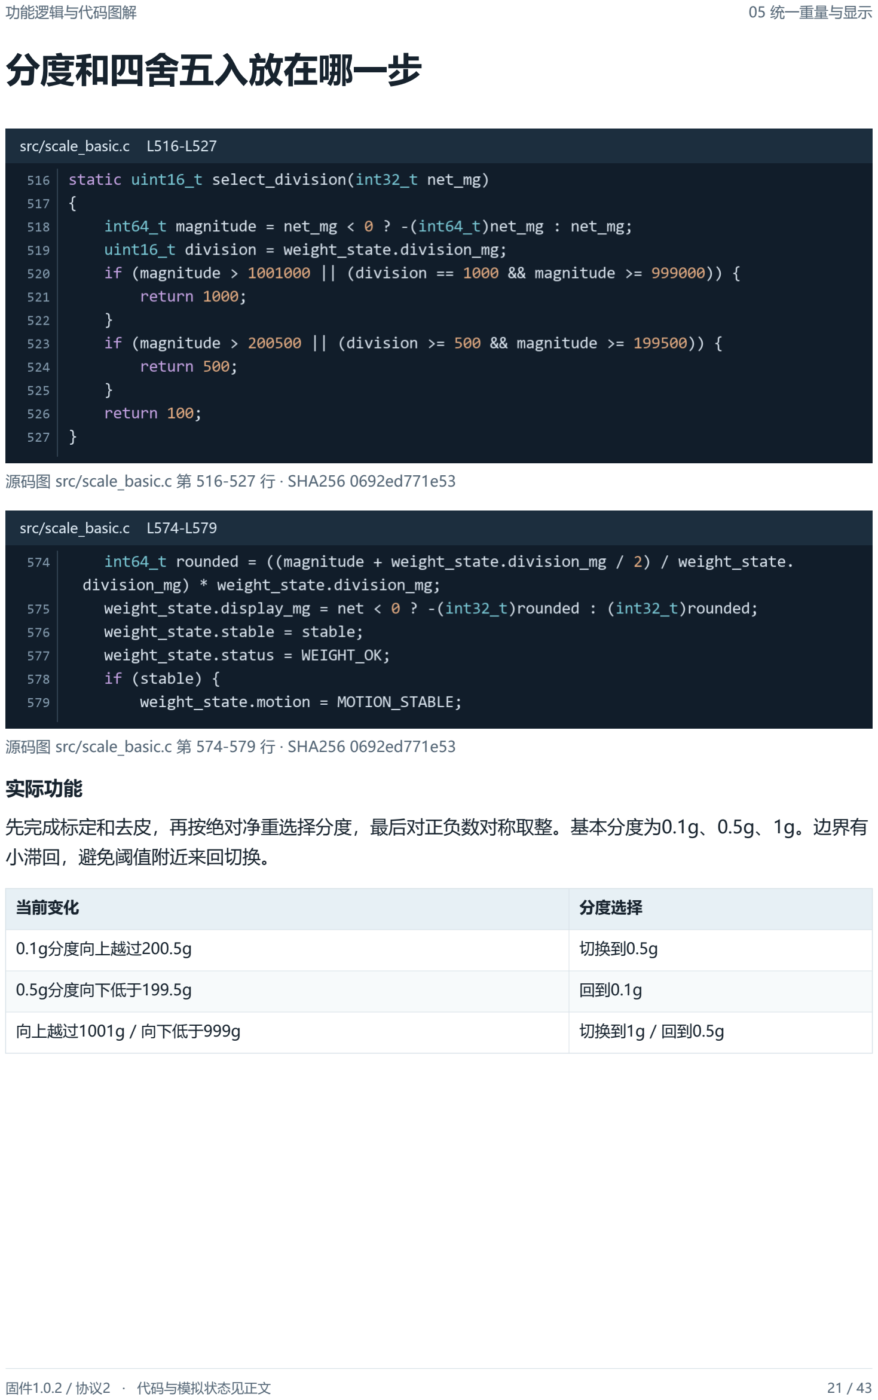
[picture p31: page 21]

功能逻辑与代码图解 | 05 统一重量与显示

源码图 src/scale_basic.c 第 516-527 行 · SHA256 0692ed771e53

源码图 src/scale_basic.c 第 574-579 行 · SHA256 0692ed771e53

### 实际功能

### 先完成标定和去皮，再按绝对净重选择分度，最后对正负数对称取整。基本分度为0.1g、0.5g、1g。边界有 小滞回，避免阈值附近来回切换。

当前变化 | 分度选择
0.1g分度向上越过200.5g | 切换到0.5g
0.5g分度向下低于199.5g | 回到0.1g
向上越过1001g / 向下低于999g | 切换到1g / 回到0.5g

功能逻辑与代码图解 | 05 统一重量与显示

# 重量状态怎样变成一帧数据

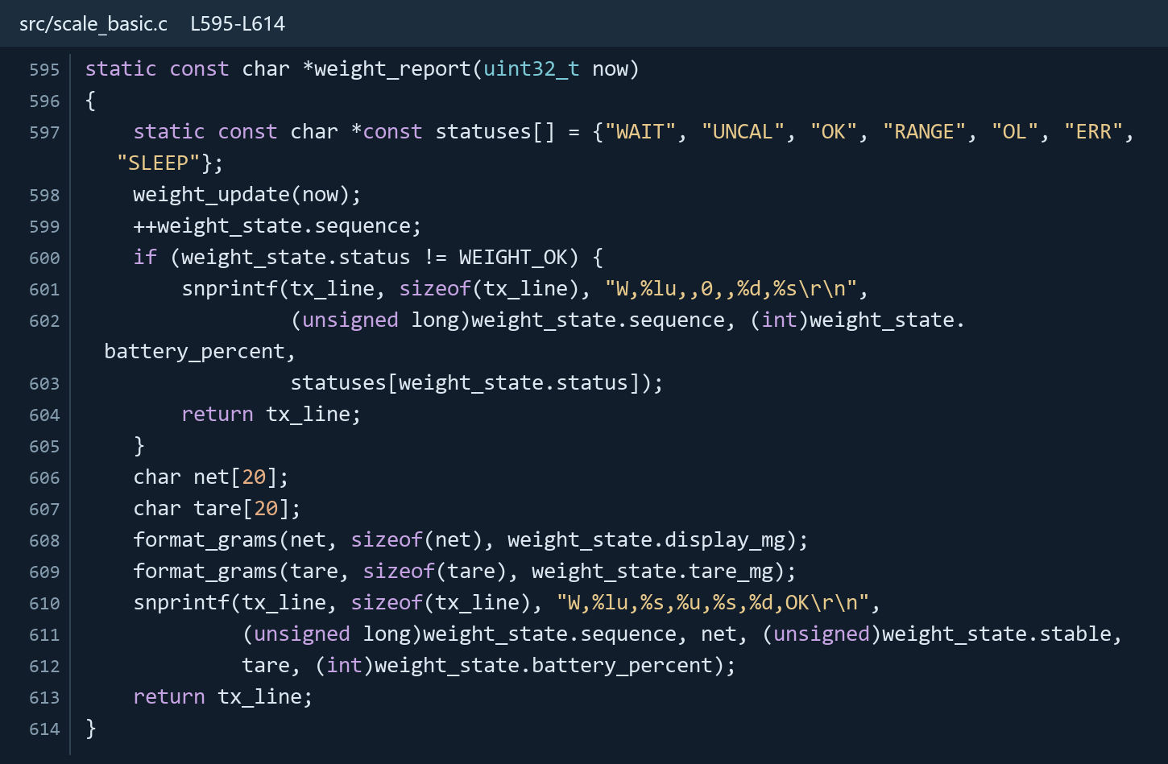
[picture p32: figure]

源码图 src/scale_basic.c 第 595-614 行 · SHA256 0692ed771e53

### 实际功能

### 每次生成重量帧，序号加1。正常帧包含净重、稳定、皮重、电量和OK。电量当前为-1，表示尚未取得百分

比。g/kg是显示设置，串口协议的重量字段统一使用克。

W,1024,136.4,1,120.0,-1,OK

W,1025,,0,,-1,OL

示例第一帧表示净重136.4g、皮重120g，毛重为256.4g。第二帧表示超载，两个重量字段留空。READ也会 生成这种帧，周期刷新由STREAM和RATE控制。

功能逻辑与代码图解 | 06 通信与命令

# UART怎样收到一条完整命令

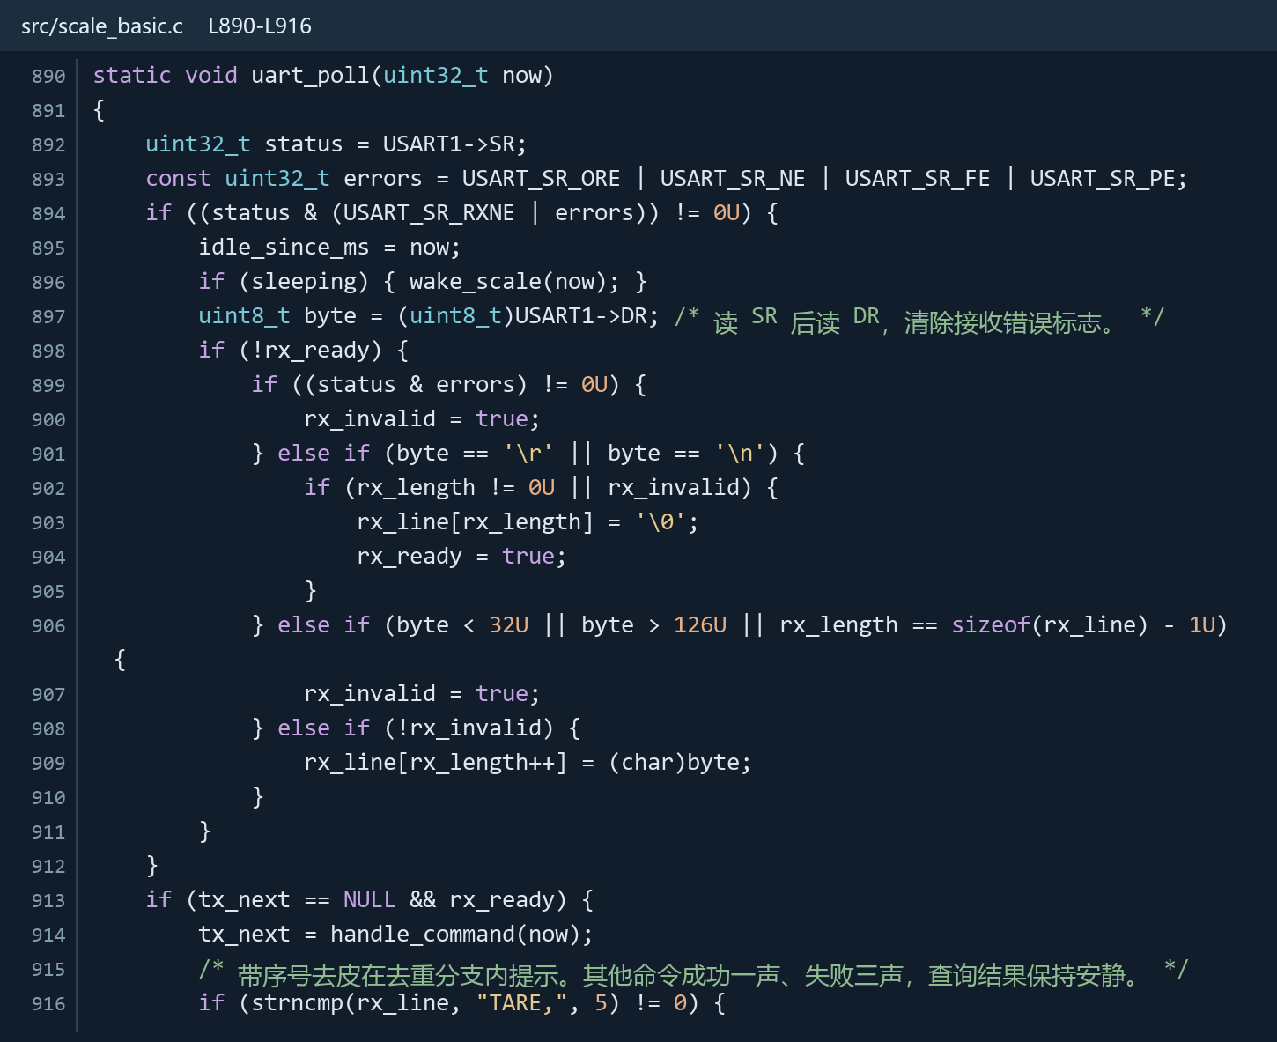
[picture p33: figure]

源码图 src/scale_basic.c 第 890-916 行 · SHA256 0692ed771e53

### 实际功能

### 逐字节接收ASCII，遇到CR或LF才结束一行。CRLF中的空换行会被忽略。收到非打印字符、超长行或串口错 误后，整行一直作废到行尾，避免截断文本被当成有效命令。

### 接收缓冲最多47个字符，另留一个字符串结束符。收到任何串口数据都会更新无操作时间，待机中还会先唤 醒。设备只保留一条等待执行的命令，平板应在完整应答后发送下一条。

功能逻辑与代码图解 | 06 通信与命令

# 命令执行和发送怎样衔接

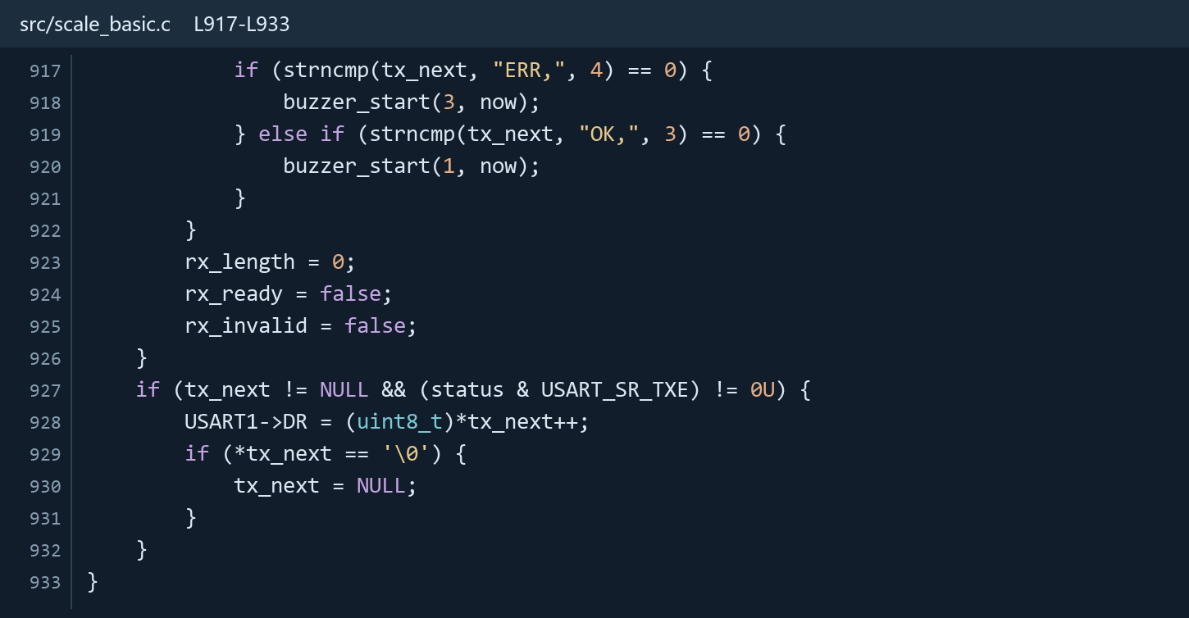
[picture p34: figure]

源码图 src/scale_basic.c 第 917-933 行 · SHA256 0692ed771e53

### 实际功能

### 上一段发送完成后，才执行已接收的命令并取得应答指针。TXE允许发送时，每轮只写一个字节。共用发送 缓冲在这段时间保持该帧内容，完整发完再接下一条。

普通命令返回OK时一声，返回ERR时三声，正常查询保持安静。带序号TARE由专门去重分支提示，重复应

### 答不重复去皮或响铃。静音模式下仍会发送相同的成功或错误报文。

功能逻辑与代码图解 | 06 通信与命令

# 去皮序号怎样阻止重复执行

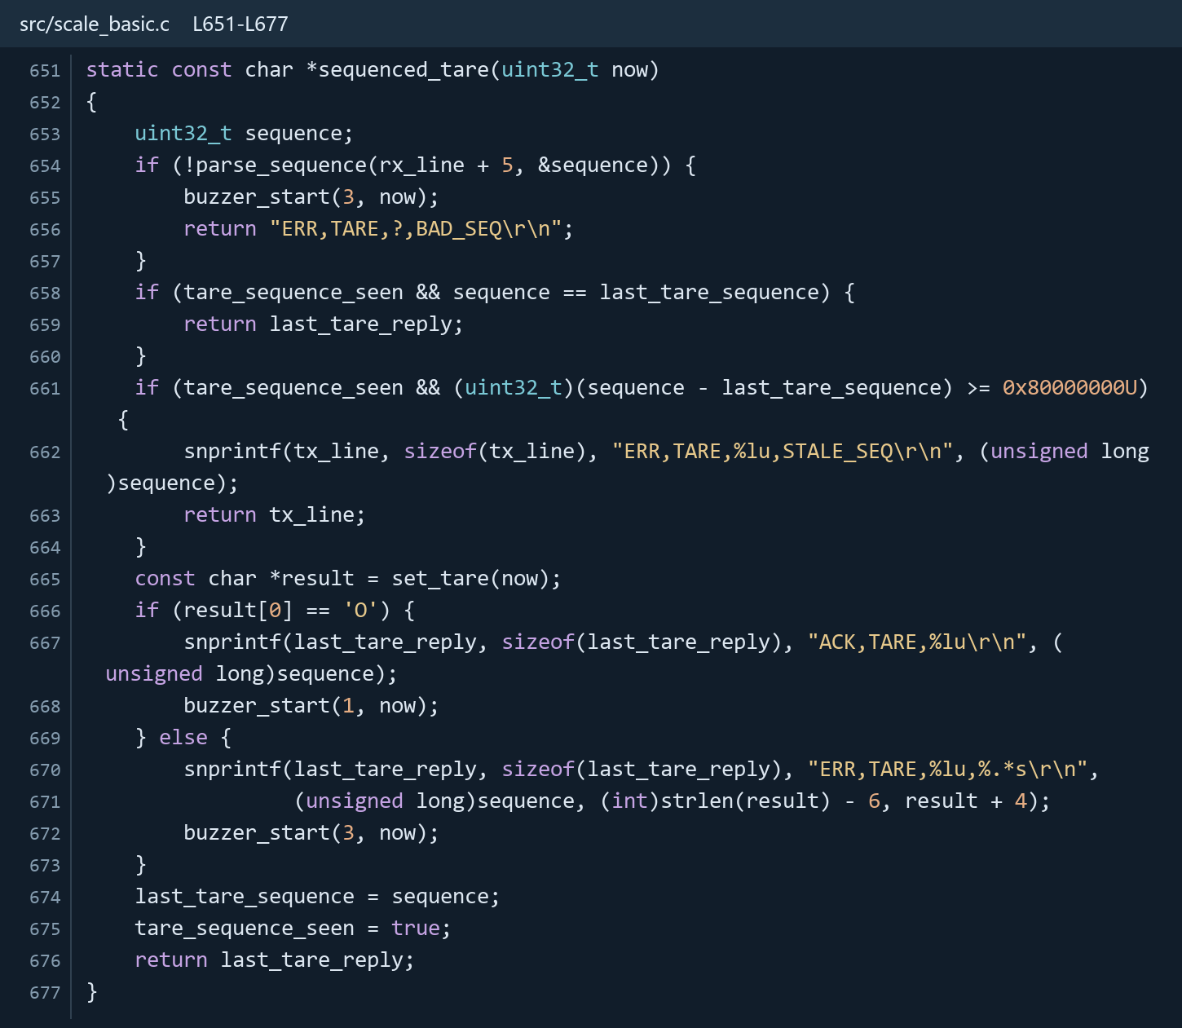
[picture p35: figure]

源码图 src/scale_basic.c 第 651-677 行 · SHA256 0692ed771e53

### 实际功能

重发最近一次序号，直接返回保存的原应答；更早序号返回STALE_SEQ。新序号才会实际调用去皮。成功和

### 失败的应答都会缓存，因此失败后重新尝试应使用新序号。

序号范围为0～4294967295，允许从最大值回绕到0。去重缓存属于本次运行的RAM状态，掉电后重新建立

### 交互。简单TARE保留给手动联调，平板应使用带序号形式。

功能逻辑与代码图解 | 06 通信与命令

# 命令分派与查询入口

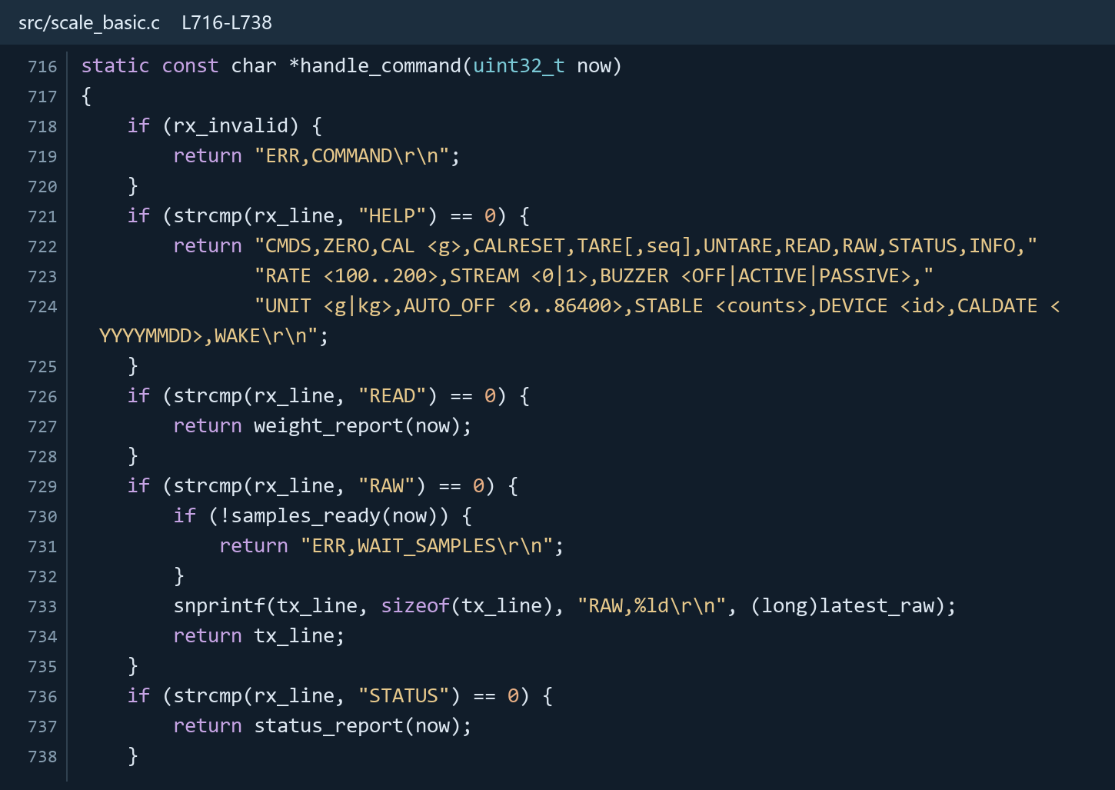
[picture p36: figure]

源码图 src/scale_basic.c 第 716-738 行 · SHA256 0692ed771e53

### 实际功能

类别 | 入口与结果
查询 | HELP命令列表；STATUS运行状态；INFO版本与编号
测量 | READ重量帧；RAW最新有效原始计数
测量操作 | ZERO、CAL、CALRESET、TARE、UNTARE
运行设置 | RATE、STREAM、WAKE与固定LIMIT兼容入口
持久设置 | STABLE、BUZZER、UNIT、AUTO_OFF、DEVICE、CALDATE

### 命令名称按大小写精确匹配。数字参数要求非负整数，单位、符号或多余空格会被拒绝。完整参数范围和应 答字串见操作指南的命令页。

# 设置为何先保存再生效

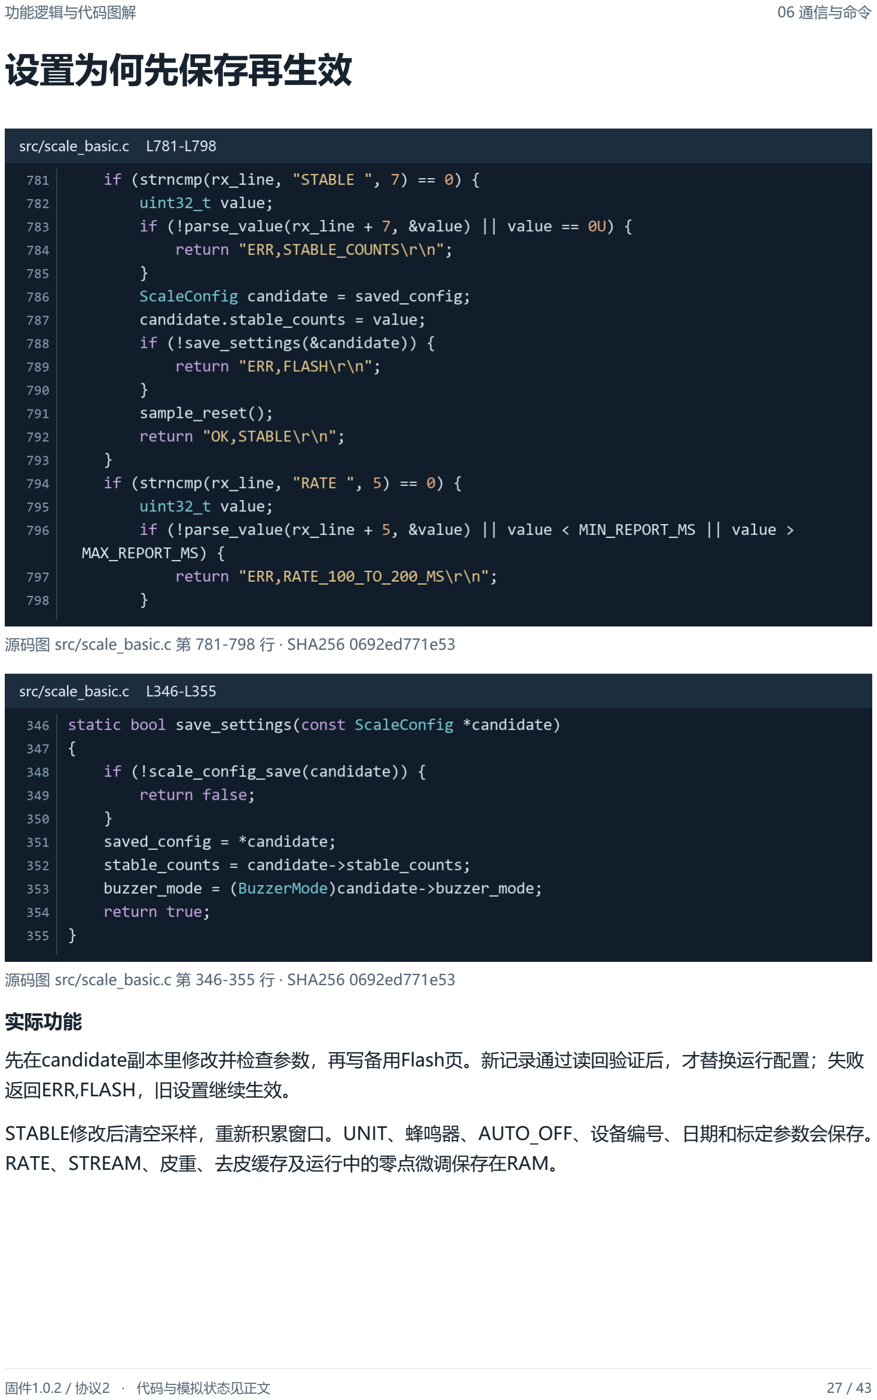
[picture p37: page 27]

功能逻辑与代码图解 | 06 通信与命令

源码图 src/scale_basic.c 第 781-798 行 · SHA256 0692ed771e53

源码图 src/scale_basic.c 第 346-355 行 · SHA256 0692ed771e53

### 实际功能

先在candidate副本里修改并检查参数，再写备用Flash页。新记录通过读回验证后，才替换运行配置；失败 返回ERR,FLASH，旧设置继续生效。

STABLE修改后清空采样，重新积累窗口。UNIT、蜂鸣器、AUTO_OFF、设备编号、日期和标定参数会保存。 RATE、STREAM、皮重、去皮缓存及运行中的零点微调保存在RAM。

功能逻辑与代码图解 | 07 按键与提示

# SW4怎样区分短按和长按

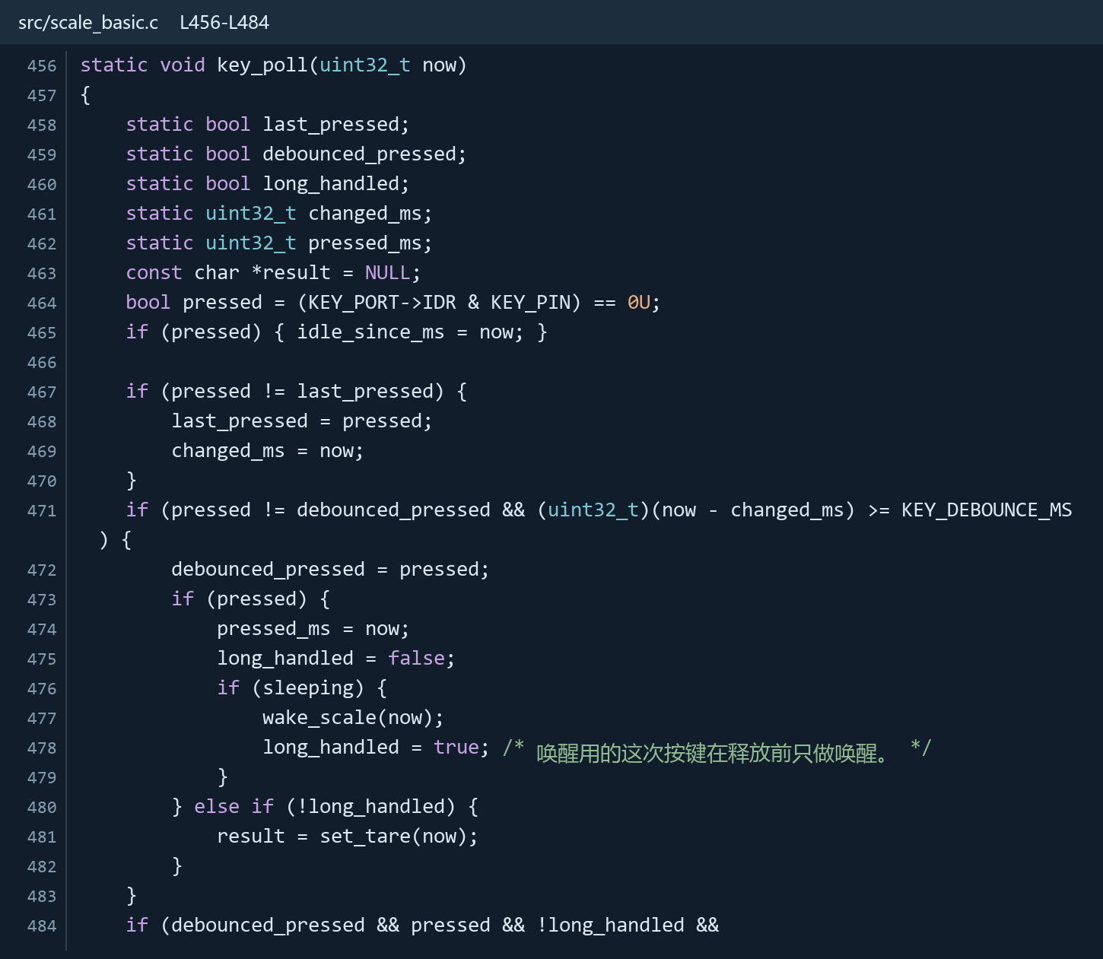
[picture p38: figure]

源码图 src/scale_basic.c 第 456-484 行 · SHA256 0692ed771e53

### 按下和释放都要连续保持30ms才接受。短按在释放后去皮；按住至1.5秒执行空秤归零，每次长按只处理一

次，释放后不再去皮。

待机时，第一次按下只唤醒。pressed_ms、long_handled记住本次按压进度。按键操作成功一声，失败三

### 声，实际错误仍由稳定、新鲜度、空秤与总负载条件决定。

功能逻辑与代码图解 | 07 按键与提示

# 蜂鸣器如何分段响而不阻塞

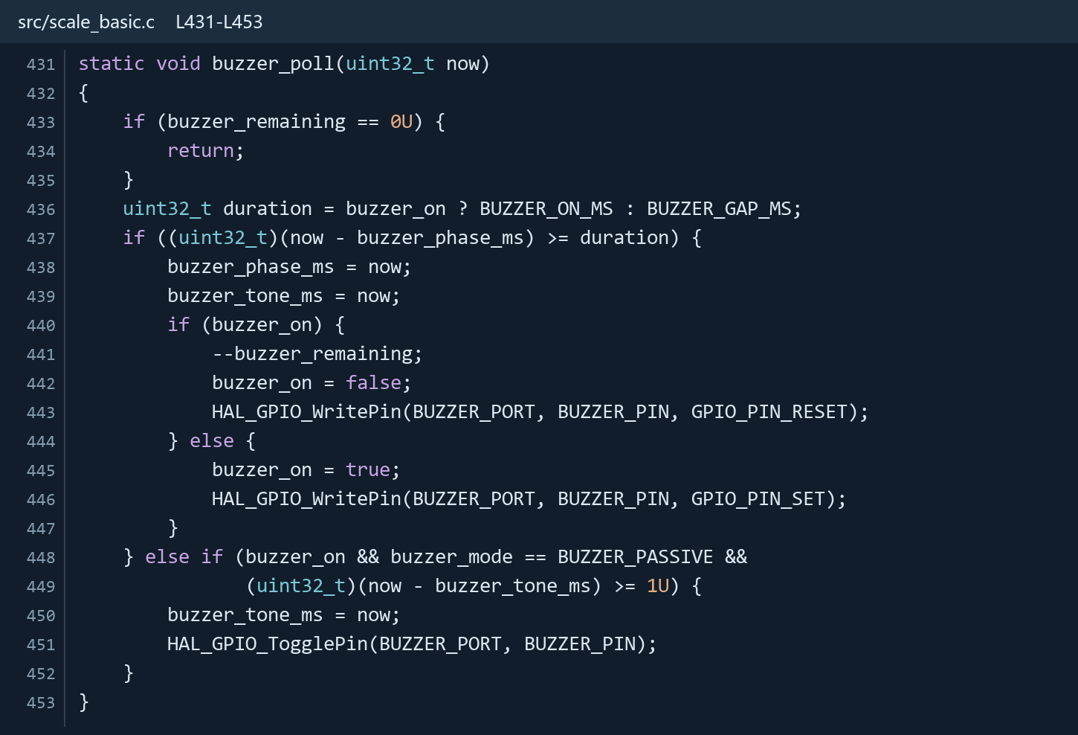
[picture p39: figure]

源码图 src/scale_basic.c 第 431-453 行 · SHA256 0692ed771e53

buzzer_start记录剩余声数并拉高PA1。buzzer_poll按毫秒切换120ms发声和100ms间隔，期间继续采样、

### 收发和检测按键。

模式或事件 | 代码行为
OFF | 默认静音，保留协议结果和错误状态
ACTIVE | 高电平持续通断，配合有源蜂鸣器
PASSIVE | 约每1ms翻转，形成约500Hz联调音调
持续传感器故障或超载 | 每2秒启动三声提示

功能逻辑与代码图解 | 08 空秤与电源

# 哪些条件允许慢速零点跟踪

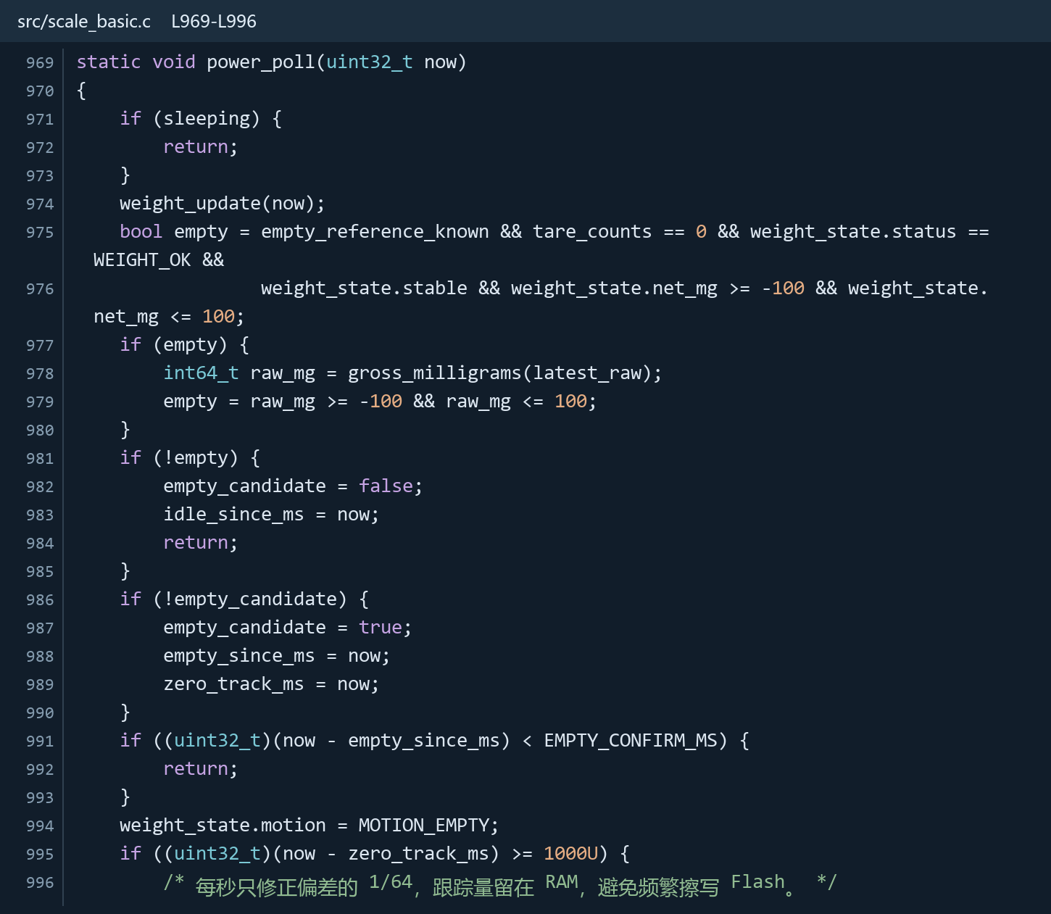
[picture p40: figure]

源码图 src/scale_basic.c 第 969-996 行 · SHA256 0692ed771e53

### 需要已有空秤参考、皮重为0、重量有效且稳定，滤波净重与最新原始换算值都在±0.1g内。满足后进入候选 ，连续至少3秒才允许慢速跟踪。

### 任一条件失效就取消候选并重置无操作时间。0.5g、1g、2g负载会阻止跟踪与自动待机。平板连续向串口发 送查询，也会持续重置无操作计时。

# 120秒后具体关闭哪些部分

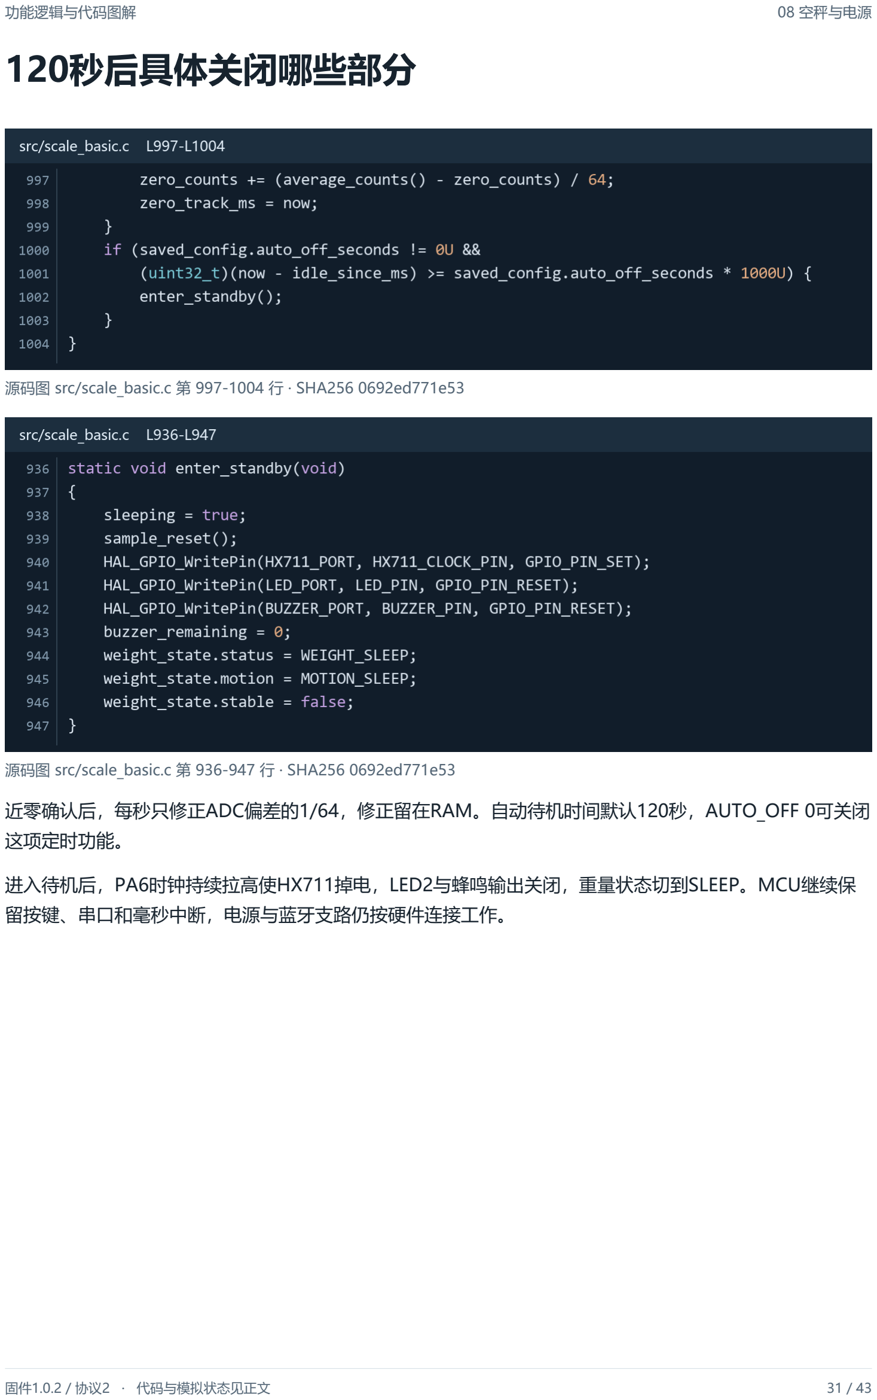
[picture p41: page 31]

功能逻辑与代码图解 | 08 空秤与电源

源码图 src/scale_basic.c 第 997-1004 行 · SHA256 0692ed771e53

源码图 src/scale_basic.c 第 936-947 行 · SHA256 0692ed771e53

近零确认后，每秒只修正ADC偏差的1/64，修正留在RAM。自动待机时间默认120秒，AUTO_OFF 0可关闭

### 这项定时功能。

进入待机后，PA6时钟持续拉高使HX711掉电，LED2与蜂鸣输出关闭，重量状态切到SLEEP。MCU继续保

### 留按键、串口和毫秒中断，电源与蓝牙支路仍按硬件连接工作。

功能逻辑与代码图解 | 08 空秤与电源

# 唤醒后为何先出现WAIT

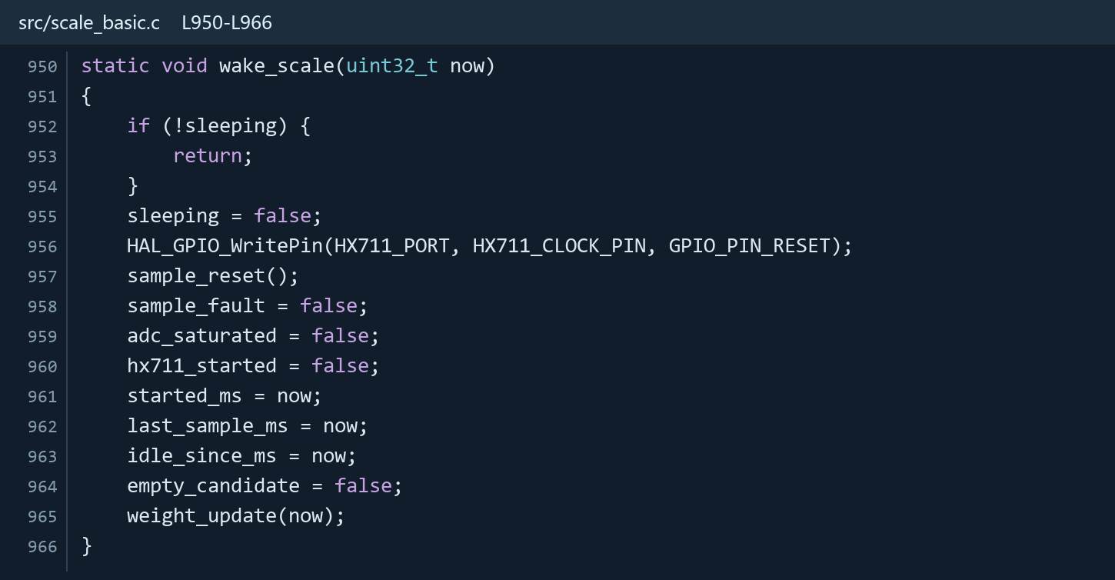
[picture p42: figure]

源码图 src/scale_basic.c 第 950-966 行 · SHA256 0692ed771e53

### 唤醒将HX711时钟拉低，清空旧窗口，重置启动建立时间和错误标志，等待新的有效采样。状态先回到

WAIT，再按是否已标定进入OK或UNCAL。

SW4或任何串口数据都可唤醒，WAKE命令会得到OK,WAKE。自动待机保持RAM，复位则会重新读取Flash。

### 两者对皮重、序号缓存和临时上报设置的影响不同，详见操作指南。

# 哪些配置会掉电保存

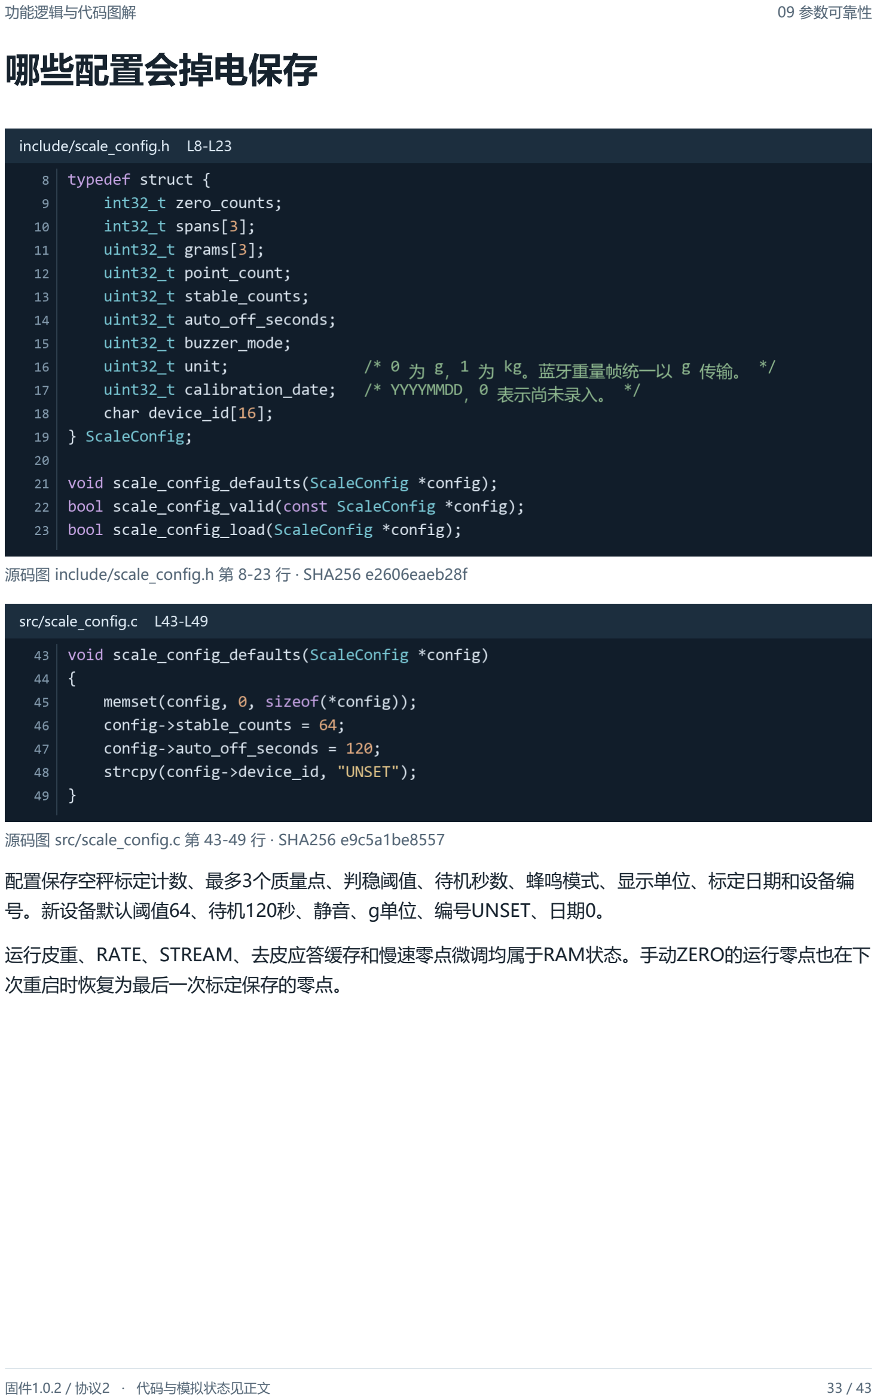
[picture p43: page 33]

功能逻辑与代码图解 | 09 参数可靠性

源码图 include/scale_config.h 第 8-23 行 · SHA256 e2606eaeb28f

源码图 src/scale_config.c 第 43-49 行 · SHA256 e9c5a1be8557

### 配置保存空秤标定计数、最多3个质量点、判稳阈值、待机秒数、蜂鸣模式、显示单位、标定日期和设备编

号。新设备默认阈值64、待机120秒、静音、g单位、编号UNSET、日期0。

运行皮重、RATE、STREAM、去皮应答缓存和慢速零点微调均属于RAM状态。手动ZERO的运行零点也在下

### 次重启时恢复为最后一次标定保存的零点。

# CRC如何识别未完成的记录

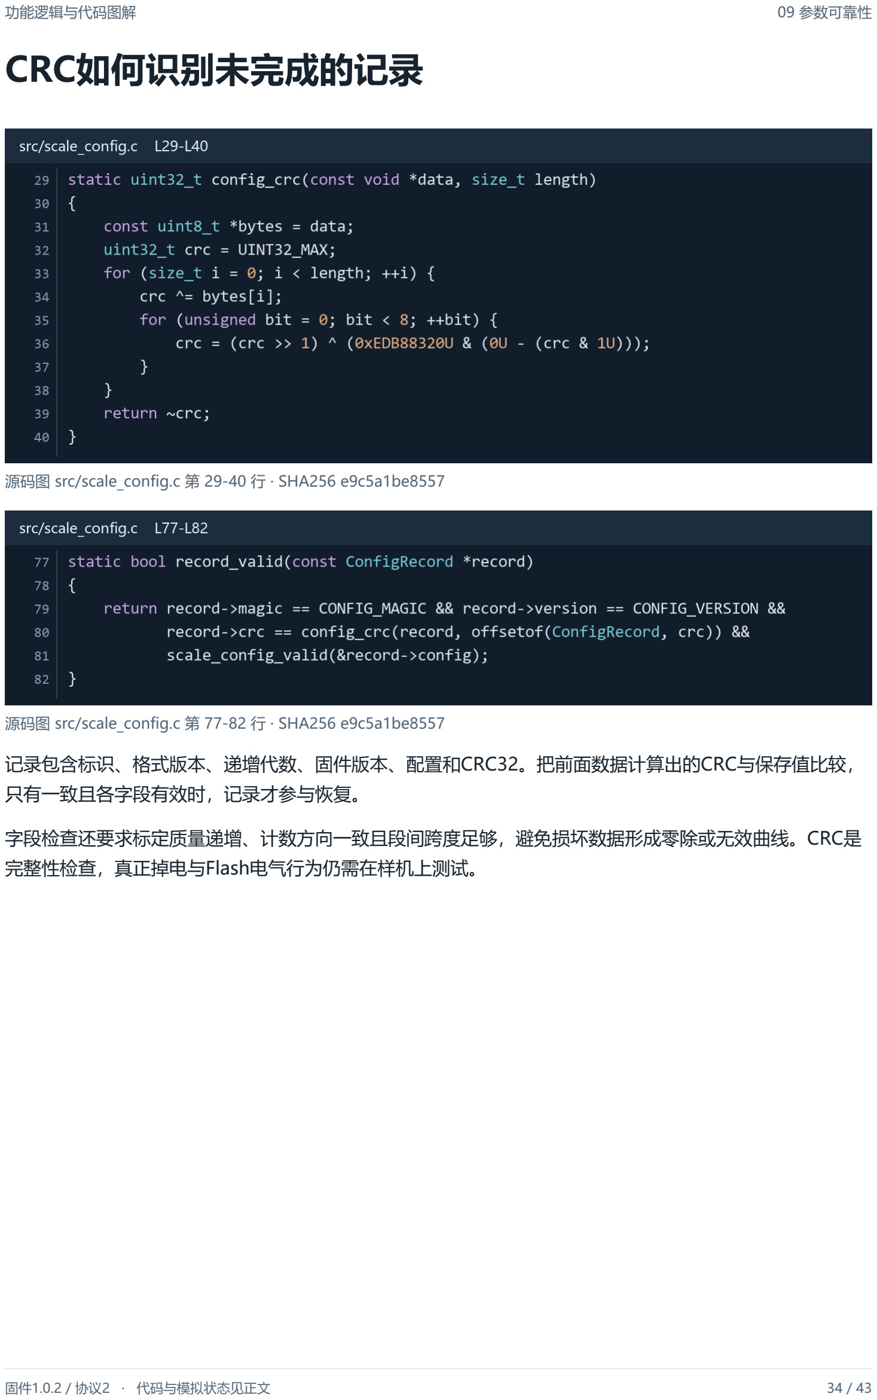
[picture p44: page 34]

功能逻辑与代码图解 | 09 参数可靠性

源码图 src/scale_config.c 第 29-40 行 · SHA256 e9c5a1be8557

源码图 src/scale_config.c 第 77-82 行 · SHA256 e9c5a1be8557

### 记录包含标识、格式版本、递增代数、固件版本、配置和CRC32。把前面数据计算出的CRC与保存值比较， 只有一致且各字段有效时，记录才参与恢复。

### 字段检查还要求标定质量递增、计数方向一致且段间跨度足够，避免损坏数据形成零除或无效曲线。CRC是 完整性检查，真正掉电与Flash电气行为仍需在样机上测试。

# 两份记录如何选新与回退

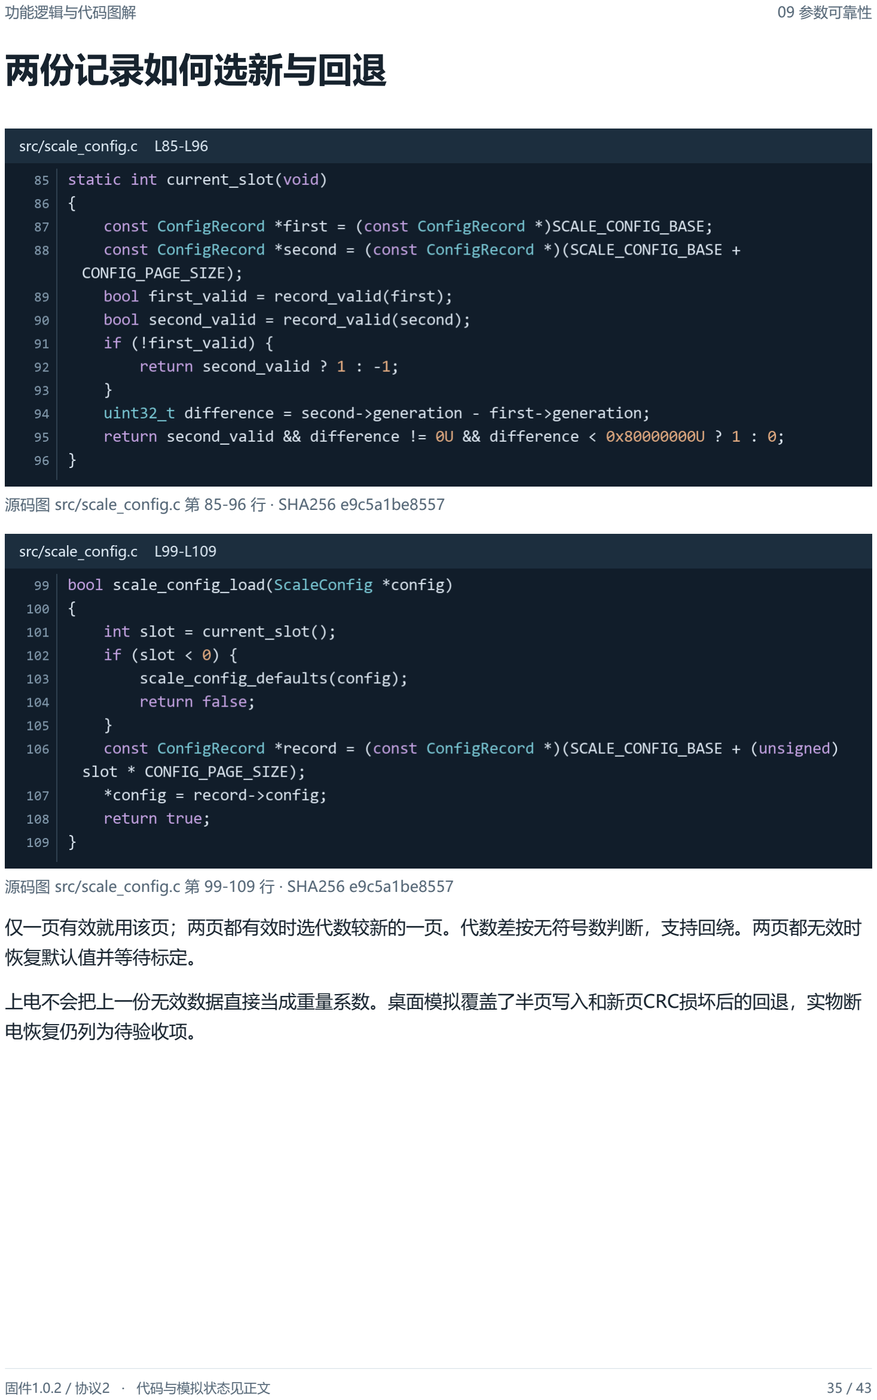
[picture p45: page 35]

功能逻辑与代码图解 | 09 参数可靠性

源码图 src/scale_config.c 第 85-96 行 · SHA256 e9c5a1be8557

源码图 src/scale_config.c 第 99-109 行 · SHA256 e9c5a1be8557

### 仅一页有效就用该页；两页都有效时选代数较新的一页。代数差按无符号数判断，支持回绕。两页都无效时 恢复默认值并等待标定。

上电不会把上一份无效数据直接当成重量系数。桌面模拟覆盖了半页写入和新页CRC损坏后的回退，实物断

### 电恢复仍列为待验收项。

功能逻辑与代码图解 | 09 参数可靠性

# 保存前怎样保留旧记录

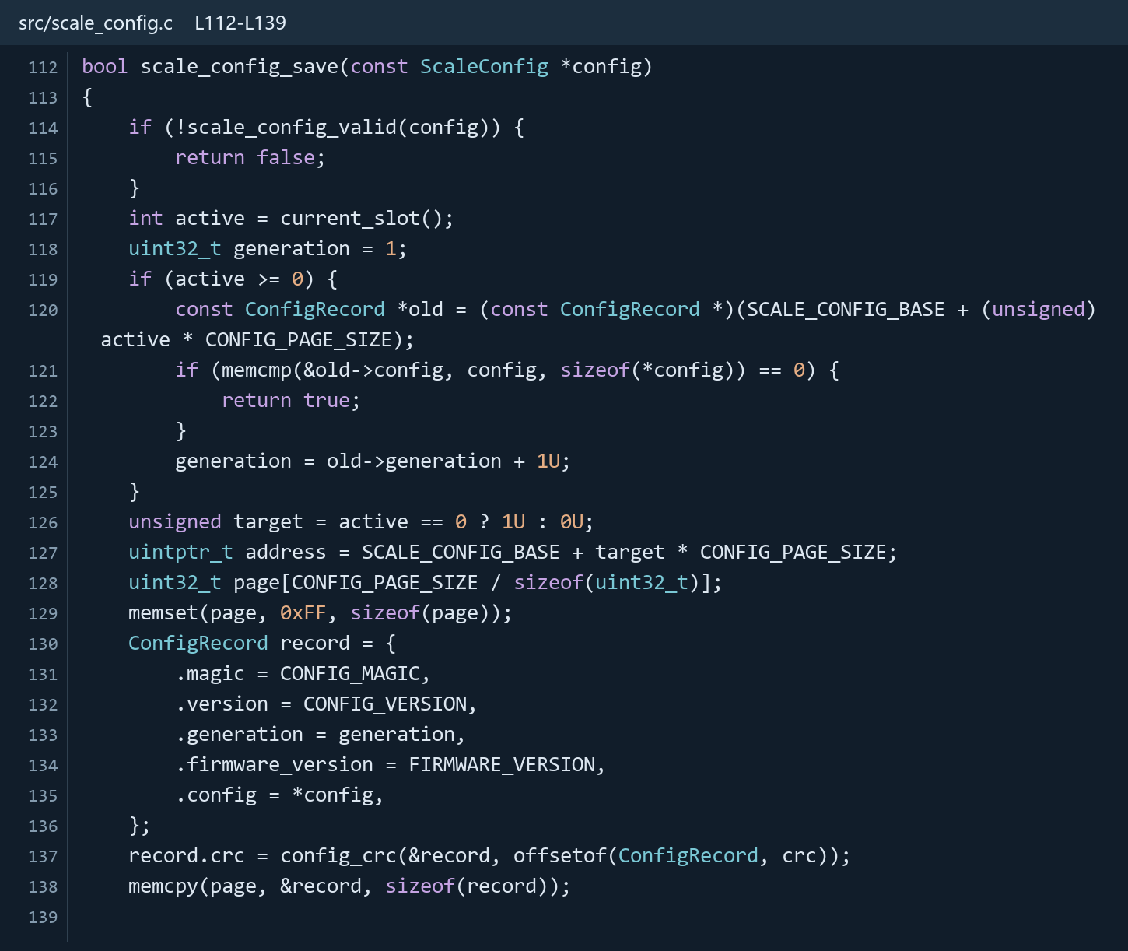
[picture p46: figure]

源码图 src/scale_config.c 第 112-139 行 · SHA256 e9c5a1be8557

### 配置先做范围和单调性检查。与当前有效配置相同时跳过写入；有变化时递增代数，选择另一页作目标，把

完整记录放进128字节的RAM页缓冲。

目标页始终是备用页，当前有效页在本次保存中保留。程序区只占前16KB，最后4KB扇区专用于参数，避免 普通固件扇区擦写覆盖配置。

功能逻辑与代码图解 | 09 参数可靠性

# 写入成功的判断放在哪一步

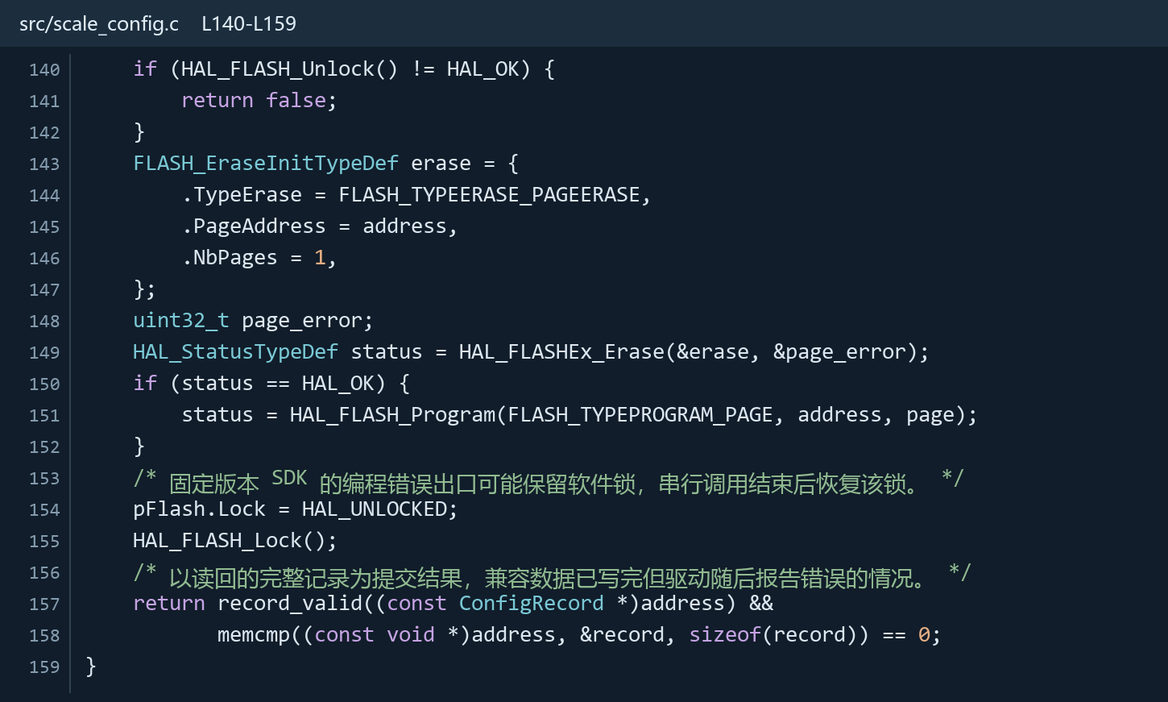
[picture p47: figure]

源码图 src/scale_config.c 第 140-159 行 · SHA256 e9c5a1be8557

解锁后按128字节页擦除，再写入新页并锁回Flash。最后读回整个记录，比较头部、数据和CRC，确认与本

### 次候选记录完全一致，才应用到运行状态。

### 驱动报错但完整记录已经落盘时，以读回验证作为提交结果。数据不完整时继续使用旧页。Flash编程例程由 链接脚本复制到RAM执行，上传参数使用扇区擦除。

# 主循环卡住时怎样恢复

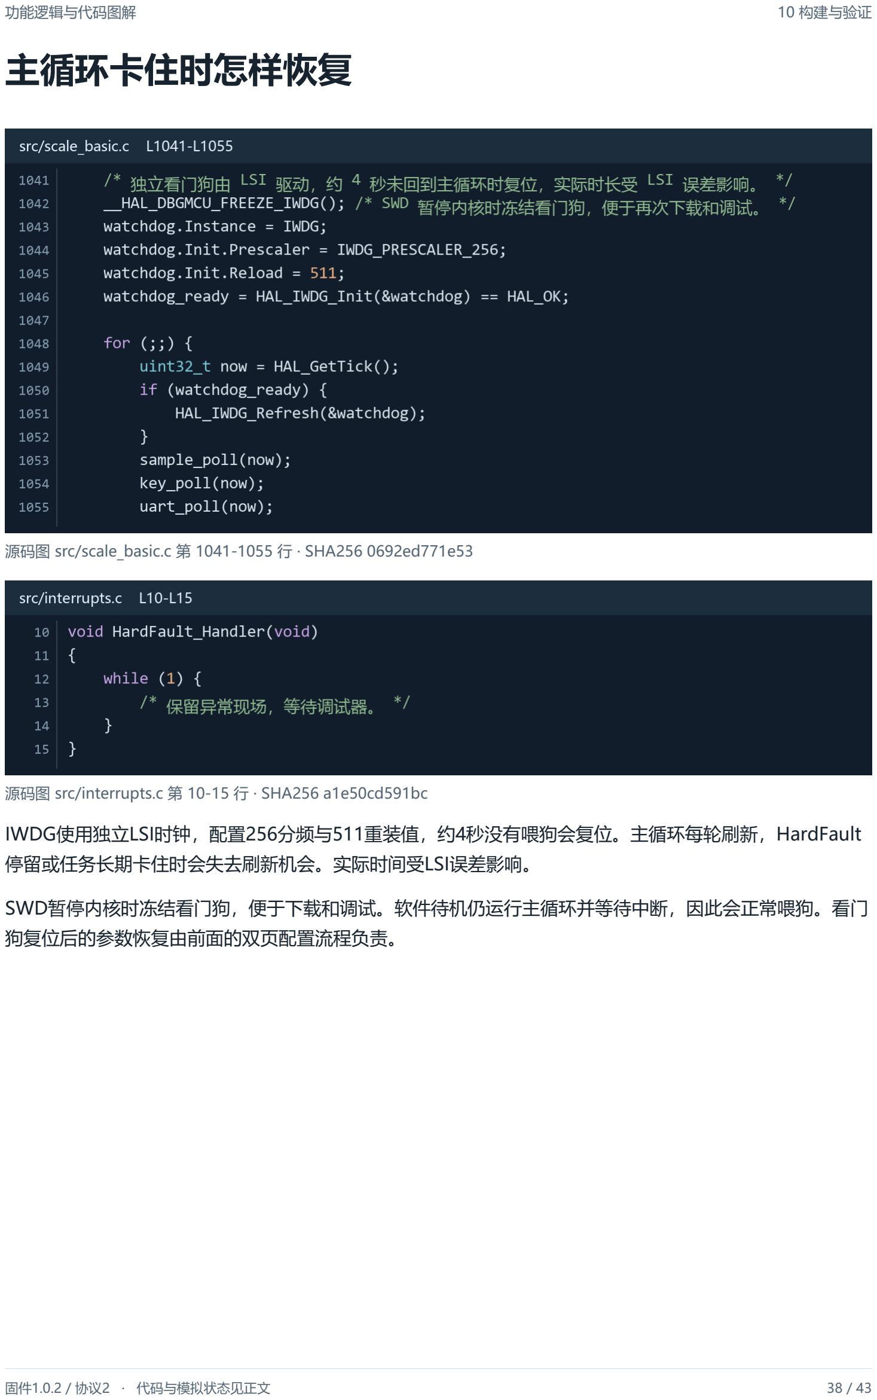
[picture p48: page 38]

功能逻辑与代码图解 | 10 构建与验证

源码图 src/scale_basic.c 第 1041-1055 行 · SHA256 0692ed771e53

源码图 src/interrupts.c 第 10-15 行 · SHA256 a1e50cd591bc

IWDG使用独立LSI时钟，配置256分频与511重装值，约4秒没有喂狗会复位。主循环每轮刷新，HardFault

### 停留或任务长期卡住时会失去刷新机会。实际时间受LSI误差影响。

### SWD暂停内核时冻结看门狗，便于下载和调试。软件待机仍运行主循环并等待中断，因此会正常喂狗。看门 狗复位后的参数恢复由前面的双页配置流程负责。

功能逻辑与代码图解 | 10 构建与验证

# 点灯目标和称重目标怎样选择

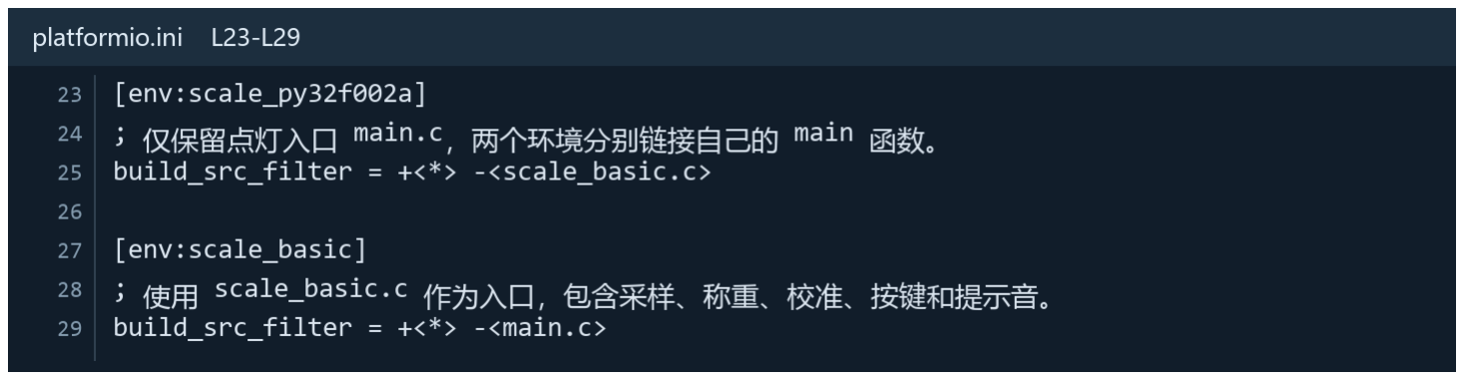
[picture p49: figure]

源码图 platformio.ini 第 23-29 行 · SHA256 bb56c9228844

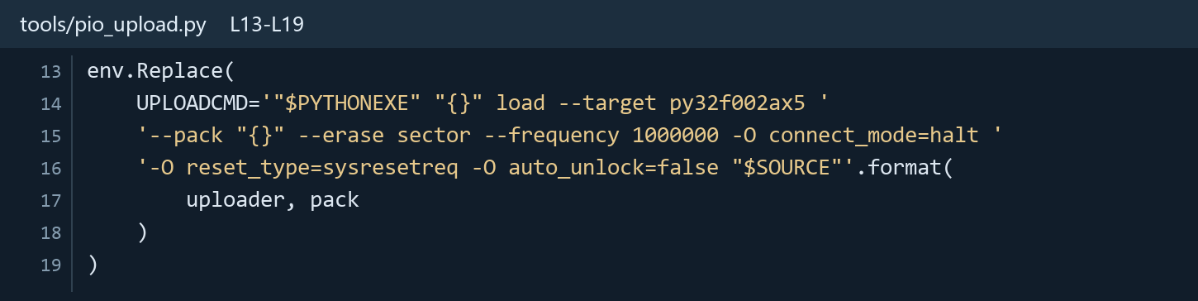
[picture p50: figure]

源码图 tools/pio_upload.py 第 13-19 行 · SHA256 0e7ede557bb6

区域或目标 | 用途
scale_py32f002a | 默认点灯目标，只运行PB0翻转入口
scale_basic | 称重、协议、按键、蜂鸣、存储与待机入口
0x08000000～0x08003FFF | 16KB程序区
0x08004000起 | 4KB配置扇区，双页位于0x4000/0x4080偏移

上传使用pyOCD、官方DFP与1MHz SWD。setup_pack.py下载并核对官方包的SHA256；该下载校验与设 备配置CRC用途不同。

功能逻辑与代码图解 | 10 构建与验证

# 哪些结论已经检查过

scale_py32f002a SUCCESS Flash 1660B RAM 1008B scale_basic SUCCESS Flash 14632B RAM 2104B Simulated settling at 10SPS: 1400ms

检查类别 | 本轮结果
实际构建 | 两个PIO环境编译并链接成功，原SDK/newlib链接警告仍存在
质量与曲线 | 三点标定、非线性去皮、满量程旧曲线误判修正
状态与交互 | 0.5g保留、负重量、边界分度、总负载、实体键、蜂鸣
通信 | CRLF、超长行、接收错误、去皮去重与uint32回绕
参数可靠性 | 有效记录内每字节位置截断、CRC损坏、擦写失败与读回提交
电源与时间 | 0.5g阻止吸零、120秒待机、UART唤醒和毫秒回绕

1.4秒来自无机械振动的算法模拟。整机±0.2/±1/±3g、10分钟漂移、四角偏载、BLE 8小时和整机24

### 小时运行需要真实样机与砝码验收。

屏幕驱动、段映射、电池ADC与低电提醒、RK3566端应用仍待接入。电量字段当前为-1，表示未知。

功能逻辑与代码图解 | 附录

# 函数索引一

### 以下页码定位功能解释，源码图中可直接查看真实行号。辅助函数与其调用场景一起说明。

函数 | 职责 | 页码
board_init | GPIO和串口初始配置 | 8
hx711_edge_delay | 8MHz下提供短边沿间隔 | 10
hx711_read | 24位读取、符号和满码检查 | 10
sample_reset | 清空原始和滤波窗口 | 11
sample_add | 中值、滑窗、峰峰值与稳定计时 | 12
sample_poll | 就绪读取和超时恢复 | 11
samples_ready | 有效样本与新鲜度检查 | 14
average_counts | 完整窗口平均 | 14
filtered_counts | 动态3点、稳定8点 | 14
gross_milligrams | 分段曲线换算 | 15
filter_seed | 去皮后重建窗口 | 18
save_settings | 保存成功后应用配置 | 27
overloaded | 5kg毛重限制 | 20
measurement_error | 就绪、稳定和可选量程检查 | 17
set_zero / set_tare | 空秤归零 / 容器去皮 | 17
buzzer_start / buzzer_poll | 提示音启动和非阻塞音型 | 29
key_poll | 消抖、短长按和待机唤醒 | 28
parse_value | 0～1000000严格整数解析 | 26
select_division | 分度滞回 | 21
weight_update | 统一状态与最终取整 | 19

功能逻辑与代码图解 | 附录

# 函数索引二

函数 | 职责 | 页码
format_grams | 把mg格式化为一位小数g | 22
weight_report | 生成W重量或故障帧 | 22
status_report | 查询运行标志和参数 | 26
parse_sequence | 完整uint32序号解析 | 25
sequenced_tare | 去皮应答缓存和旧序号拒绝 | 25
calibrate | 标定点录入与保存 | 16
handle_command | 全部命令分派 | 26
uart_poll | 逐字节收发和音型反馈 | 23
enter_standby / wake_scale | 待机进入 / 唤醒重建采样 | 31
power_poll / alarm_poll | 近零跟踪、待机和故障三声 | 30
main | 恢复配置与轮询调度 | 6
config_crc / record_valid | 记录完整性与字段检查 | 34
scale_config_defaults | 默认配置 | 33
scale_config_valid | 字段范围与曲线单调性 | 34
current_slot | 选择最新有效记录 | 35
scale_config_load | 恢复配置或默认值 | 35
scale_config_save | 双页保存与读回验证 | 36
SysTick / HardFault | 毫秒基准 / 保留故障现场 | 38
点灯main / 系统文件封装 | 最小运行验证 / SDK时钟实现 | 39

功能逻辑与代码图解 | 附录

# 依据与代码快照

[D1] 用户确认的《厨房电子秤产品需求规格书》5kg V1.0，2026年10月30日。 [D2] 用户确认的《厨房电子秤项目设计说明书》5kg V1.0，2026年10月30日。 [H1] 用户提供的电子秤原理图，Board1 / P1 / V1.0。
[H2] 嘉立创项目3D视图与用户实物图，用于器件定位。

[C1] 本地 py32-scale-pio 工程。图下SHA前缀定位文件内容，完整SHA256列于下表。 [T1] 本次PIO实际编译日志。
[T2] work/scale-host-check/check.c，模拟HAL、UART、ADC和Flash的回归检查。
文件 | SHA256
src/scale_basic.c | 0692ed771e531d16def909994164a03833ed73a6c06d3f836b70d3d412ee7 650
src/scale_config.c | e9c5a1be85572e7337b86624dd93095080173d8105bd0a2db4ebdb3cb36d 95a6
include/weight_state.h | d49d46442fe9fed2513042d8dce78a2f31efc661317435ad1051d5e25ed1e6 e5
platformio.ini | bb56c9228844d823362fe826a74e672a292ab2290e840c4d3604a3cddf612 bb3
tools/pio_upload.py | 0e7ede557bb6a212794e68c0bf2c88d3a71f4470167cd6613f7b13e46fea5ff 2

### 本册记录当前开发快照。修改代码后，行号、分度、协议或默认参数可能变化，应重新核对并生成手册。

工程位置为 C:/Users/29268/Documents/Codex/2026-10-30/new-chat/outputs/py32-scale-pio。
