lin-gengyou/py32-kitchen-scale/docs/measurements/README.md

# 实物联调记录

复制下表建立`YYYY-MM-DD_DEVICE.md`，每次从菜单09记录固件版本，并注明所用协议版本。

| 项目 | 填写内容 |
|---|---|
| 日期、人员、设备ID | |
| Git提交、FW、PROTO | |
| 传感器型号、量程、安装 | |
| 电池/电源与5V/3.3V实测 | |
| 烧录器型号、VREF模式、下载结果 | |
| 三点标定砝码与CAL_POINTS | |
| 各质量点：参考质量、示值、误差、稳定时间 | |
| 去皮、归零、负重量、总负载限制 | |
| 四角、重复10次、空秤10分钟 | |
| 提示音、120秒待机与唤醒 | |
| BLE 8小时、整机24小时 | |
| 波形、日志、问题和下一步 | |
