lin-gengyou/py32-kitchen-scale/CHANGELOG.md

# 版本变更

## v2.0.1 · 2026-11-14

- 修正S容易反复熄灭：默认按标定换算0.2g峰峰门限，首次未标定采用128计数。
- 增加进入/退出滞回，退出峰峰门限为进入门限2倍；窗口均值偏离稳定锚点1个门限也退出，覆盖慢加料。
- 重量继续实时更新，保留真实0.5g负载和变化响应；稳定不是锁定显示。
- 菜单05的0表示自动，正数仍为手动ADC计数。V4参数读取V1/V2/V3，旧默认64升级为自动，其他设置与标定保留。
- 增加静态噪声、持续显示更新、0.5g阶跃、慢加料、手动阈值及迁移回归。

## v2.0.0 · 2026-11-14

- 恢复ECB01C蓝牙9600/8N1透传：重量帧、带序号去皮、成功/失败缓存去重、心跳/状态/唤醒，RX中断缓冲与逐行发送。
- 新增浏览器客户端及协议回归，支持分包、重试、断线重连、重新订阅、旧数据清空、单位转换及演示。
- 按实机修正ADC通道选择→ADEN→建立等待→启动的顺序，每次单次转换重新使能。
- 新增PB1/内部参考异步ADC，默认外部供电；电池类型、电压/百分比、低电滞回、故障恢复和待机断ADC时钟。
- 菜单扩展至21项，电压/电源/Vref/显示绕行/蓝牙/恢复默认全部可在板上操作。
- 默认跳过已知缺段的数值第三位，5位显示与数字编辑平移；重量负号移至标题，保留5000.0g。
- 参数V3兼容V1/V2记录；新增设置与旧标定一起升级保存。
- 启动近零稳定归零，低电状态门控测量操作；无源蜂鸣器由1ms中断产生500Hz。
- GCC Oz与LTO将完整功能保持在16KB程序区；4KB标定区独立保留。
- 新增模拟8小时288000帧、24小时864000样本及电源/协议/迁移/绕行检查；四PIO目标构建。
- 提供彩屏四页面交互预览与总线/存储方案，当前固件使用段码LCD。

## v1.1.2 · 2026-11-12

- 按用户现有最大20g砝码，将默认标定点数设为1，默认单点质量设为20g。
- 砝码质量输入隐藏无用前导零，选中高位时仍显示该位0以便编辑。
- 保持5kg量程、原有标定存储和多点向导。
- 新增完整20g单点标定、保存恢复、空载/20g复放与5kg毛重限制回归检查。

## v1.1.1 · 2026-11-12

- 根据实机反馈，将上方第四位第二组段从错误地址22修正为7；数字4已由用户确认完整。
- 菜单改为01～15纯数字编号，清空菜单列表的英文长名称。
- 新增HT1621实际RAM读回，并在自检第四页1304显示比较结果；已实测32项全亮数据全部一致。
- 数字第三位全亮仍为7，定位至RAM之后的段输出通道，具体SEG12检查位置写入硬件说明。
- 新增第四位数字、控制器读回失败/匹配和数字菜单的回归检查。

## v1.1.0 · 2026-11-11

- 全部现有操作迁移至SW4短按、双击和长按；USART1与蓝牙操作入口停用，彩屏不初始化。
- 新增HT1621B段码LCD驱动，按本板U9网络转换SEG地址；显示重量、单位、稳定、皮重、设置和错误。
- 新增15项菜单、逐位数字编辑、1～3点标定向导，原始计数/设备信息/屏幕自检。
- 标定最后一点后整体提交，中途取消或保存失败保留原标定；去皮/归零使用稳定与新鲜采样门控。
- 保存刷新周期，参数格式升级V2，兼容读取V1记录与旧标定。
- 默认PIO环境改为scale_basic，保留点灯和J-Link两个替代入口。
- 覆盖实体按键时序、双击不误去皮、长按不误归零、醒来不误操作、标定草稿、存储升级和LCD编码的主机检查。

## v1.0.2

串口/蓝牙命令版，保留在firmware/v1.0.2及旧版PDF手册中。
