lin-gengyou/py32-kitchen-scale/docs/hardware/SCH_电子秤原理图_2026-10-29.pdf

# LED灯电路

## 电量监测

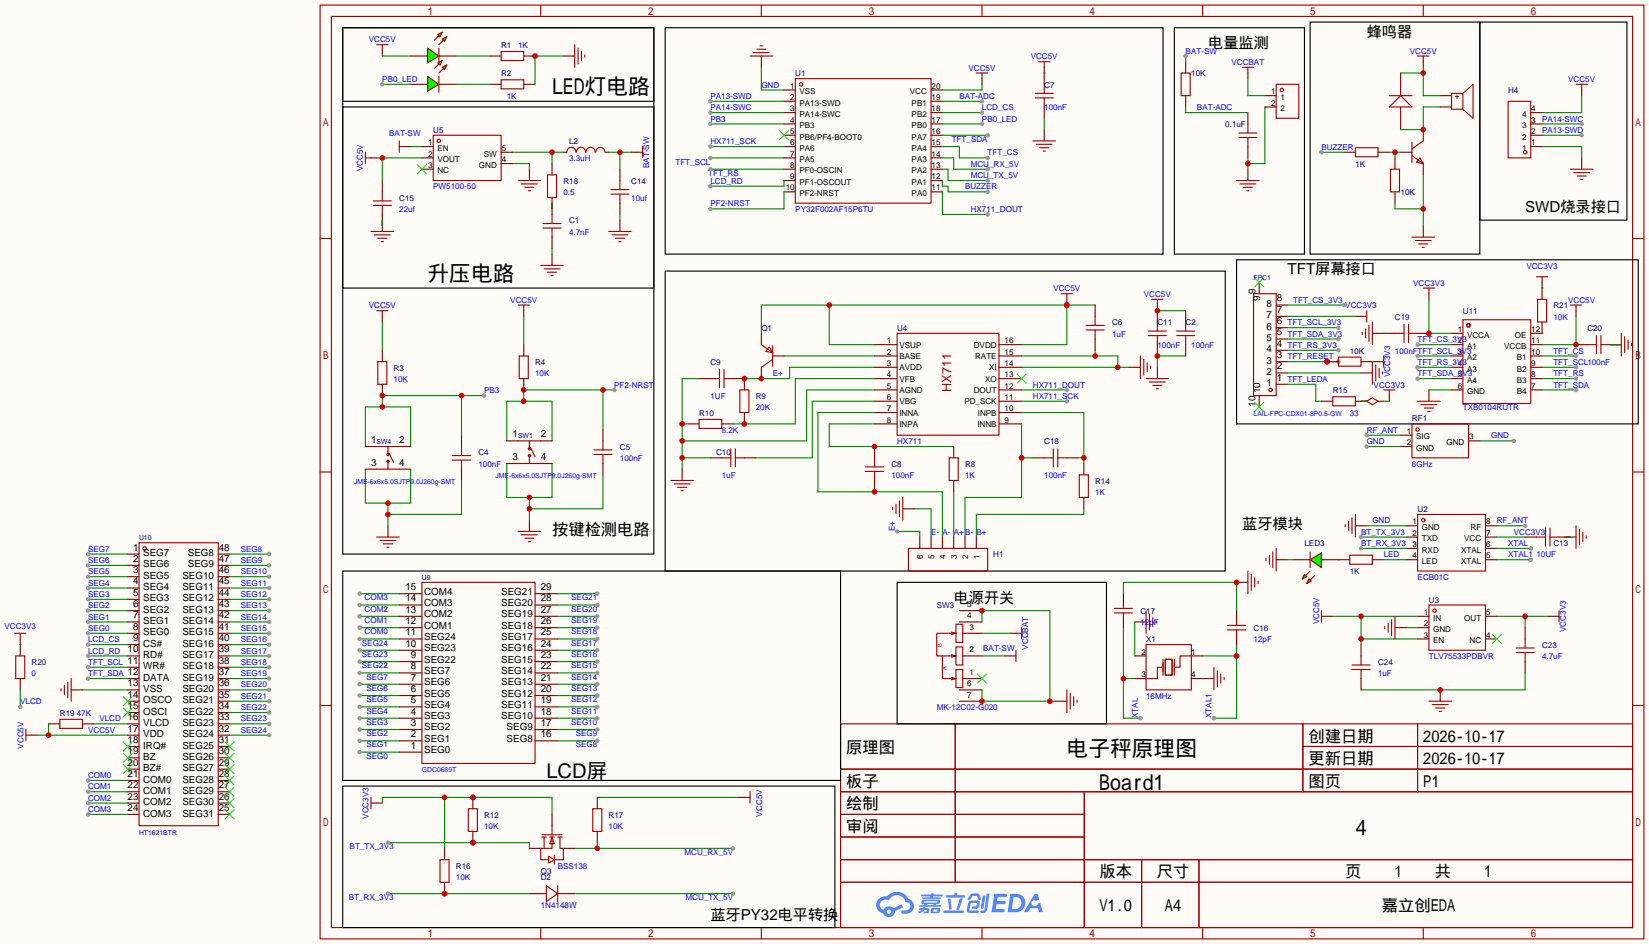
[picture p51: page 1]

原理图 | 电子秤原理图 | 创建日期 | 2026-10-17

更新日期 | 2026-10-17

板子 | Board1 | 图页 | P1
绘制
审阅

V1.0 | A4 | 嘉立创EDA
