lin-gengyou/py32-kitchen-scale/include/firmware_version.h

#ifndef SCALE_FIRMWARE_VERSION_H
#define SCALE_FIRMWARE_VERSION_H

/* 全工程共用版本号，LCD、参数记录和发布包由此保持一致。 */
#define SCALE_FIRMWARE_VERSION "2.0.1"
#define SCALE_FIRMWARE_VERSION_CODE 0x00020001U
#define SCALE_VERSION_DISPLAY "201"

#endif
