lin-gengyou/py32-kitchen-scale/(commit log)

2026-11-06 Improve SWD diagnostics for externally powered J-Link targets
2026-11-09 Avoid J-Link SDK commands before opening the probe
2026-11-09 Prepare device packs and generate flash images for all upload modes
2026-11-11 feat: release v1.1.0 with standalone button menus and segmented LCD
2026-11-12 fix: correct fourth LCD digit and add controller RAM readback in v1.1.1
    [check.c, firmware_version.h, lcd_ht1621.c, lcd_ht1621.h]
2026-11-12 feat: default to one-point 20g calibration in v1.1.2
2026-11-14 Complete board controls, power monitoring and BLE client for v2.0.0
2026-11-14 Make stability calibration-aware with exit hysteresis in v2.0.1
    [check.c, firmware_version.h, scale_basic.c, scale_config.c, scale_config.h]
